graycatlabs/UTCape/README.md

# UTCape

A BeagleBone Black cape to support unit tests in software libraries like PyBBIO 
and Bonsescript. 

The current concept would allow testing of GPIO, UART, SPI, I2C, ADC, eCAP, PWM,
and eQEP software.
