graycatlabs/UTCape/fab/UTCape-bom.xlsx

# | Designator | Quantity | Description | Manufacturer | Mfg. part number | Supplier | Supplier part number | URL
1 | C1 | 1 | CAP CER 10000PF 50V 10% X7R 0603 | Murata | GRM188R71H103KA01D | Digi-Key | 490-1512-1-ND | http://www.digikey.com/product-detail/en/GRM188R71H103KA01D/490-1512-1-ND/587862
2 | C2 C3 C4 C5 C6 C8 C9 | 7 | CAP CER 0.1UF 50V 10% X7R 0603 | Murata | GRM188R71H104KA93D | Digi-Key | 490-1519-1-ND | http://www.digikey.com/product-detail/en/GRM188R71H104KA93D/490-1519-1-ND/587854
3 | C7 | 1 | CAP CER 1000PF 50V 10% X7R 0603 | Murata | GRM188R71H102KA01D | Digi-Key | 490-1494-1-ND | http://www.digikey.com/product-detail/en/GRM188R71H102KA01D/490-1494-1-ND/587851
4 | D1 | 1 | DIODE GEN PURP 75V 150MA SOD523 | Micro Commercial Co | 1N4148X-TP | Digi-Key | 1N4148XTPMSCT-ND | http://www.digikey.com/product-detail/en/1N4148X-TP/1N4148XTPMSCT-ND/789335
5 | IC1 | 1 | IC SINGLE 2-INPUT MUX 6TSSOP | NXP Semiconductors | 74LVC1G157GW,125 | Digi-Key | 568-3008-1-ND | http://www.digikey.com/product-detail/en/74LVC1G157GW,125/568-3008-1-ND/1023416
6 | IC2 | 1 | IC EEPROM 1KBIT 10MHZ SOT23-6 | Microchip | 25LC010AT-I/OT | Digi-Key | 25LC010AT-I/OTCT-ND | http://www.digikey.com/product-detail/en/25LC010AT-I%2FOT/25LC010AT-I%2FOTCT-ND/1212542
7 | IC3 IC4 | 2 | IC EEPROM 256KBIT 400KHZ 8SOIC | Microchip | 24LC256T-I/SN | Digi-Key | 24LC256T-I/SNCT-ND | http://www.digikey.com/product-detail/en/24LC01BT-I%2FOT/24LC01BT-I%2FOTCT-ND/721417
8 | IC5 | 1 | IC OSC SGL TIMER 2.1MHZ 8-SOIC | Texas Instruments | TLC555CDR | Digi-Key | 296-1336-1-ND | http://www.digikey.com/product-detail/en/TLC555CDR/296-1336-1-ND/404959
9 | J1, J2 | 1 | CONN HEADER .100" DUAL STR 46POS | Sullins Connector Solutions | PREC023DAAN-RC | Digi-Key | S2012EC-23-ND | http://www.digikey.com/product-detail/en/PREC023DAAN-RC/S2012EC-23-ND/2774871
10 | R1 R2 R3 R4 R5 R6 R7 R8 R10 R18 | 10 | RES SMD 5.6K OHM 1% 1/10W 0603 | Rohm Semiconductor | MCR03ERTF5601 | Digi-Key | RHM5.6KCFCT-ND | http://www.digikey.com/product-detail/en/MCR03ERTF5601/RHM5.6KCFCT-ND/4084252
11 | R9 R11 R13 R14 | 4 | RES SMD 10K OHM 1% 1/10W 0603 | Rohm Semiconductor | MCR03EZPFX1002 | Digi-Key | RHM10.0KHCT-ND | http://www.digikey.com/product-detail/en/MCR03EZPFX1002/RHM10.0KHCT-ND/628332
12 | R12 R15 R16 R17 R19 R20 | 6 | RES SMD 100 OHM 1% 1/10W 0603 | Rohm Semiconductor | MCR03ERTF1000 | Digi-Key | RHM100CFCT-ND | http://www.digikey.com/product-detail/en/MCR03ERTF1000/RHM100CFCT-ND/2796458
13 | TP1 TP2 TP3 TP4 TP5 TP6 TP7 TP8 TP9 TP10 TP11 TP12 TP13 TP14 TP15 TP16 TP17 | 17 | PC TEST POINT COMPACT SMT | Keystone Electronics | 5016 | Digi-Key | 5016KCT-ND | http://www.digikey.com/product-detail/en/5016/5016KCT-ND/278888
