graycatlabs/UTCape/UTCape.pdf

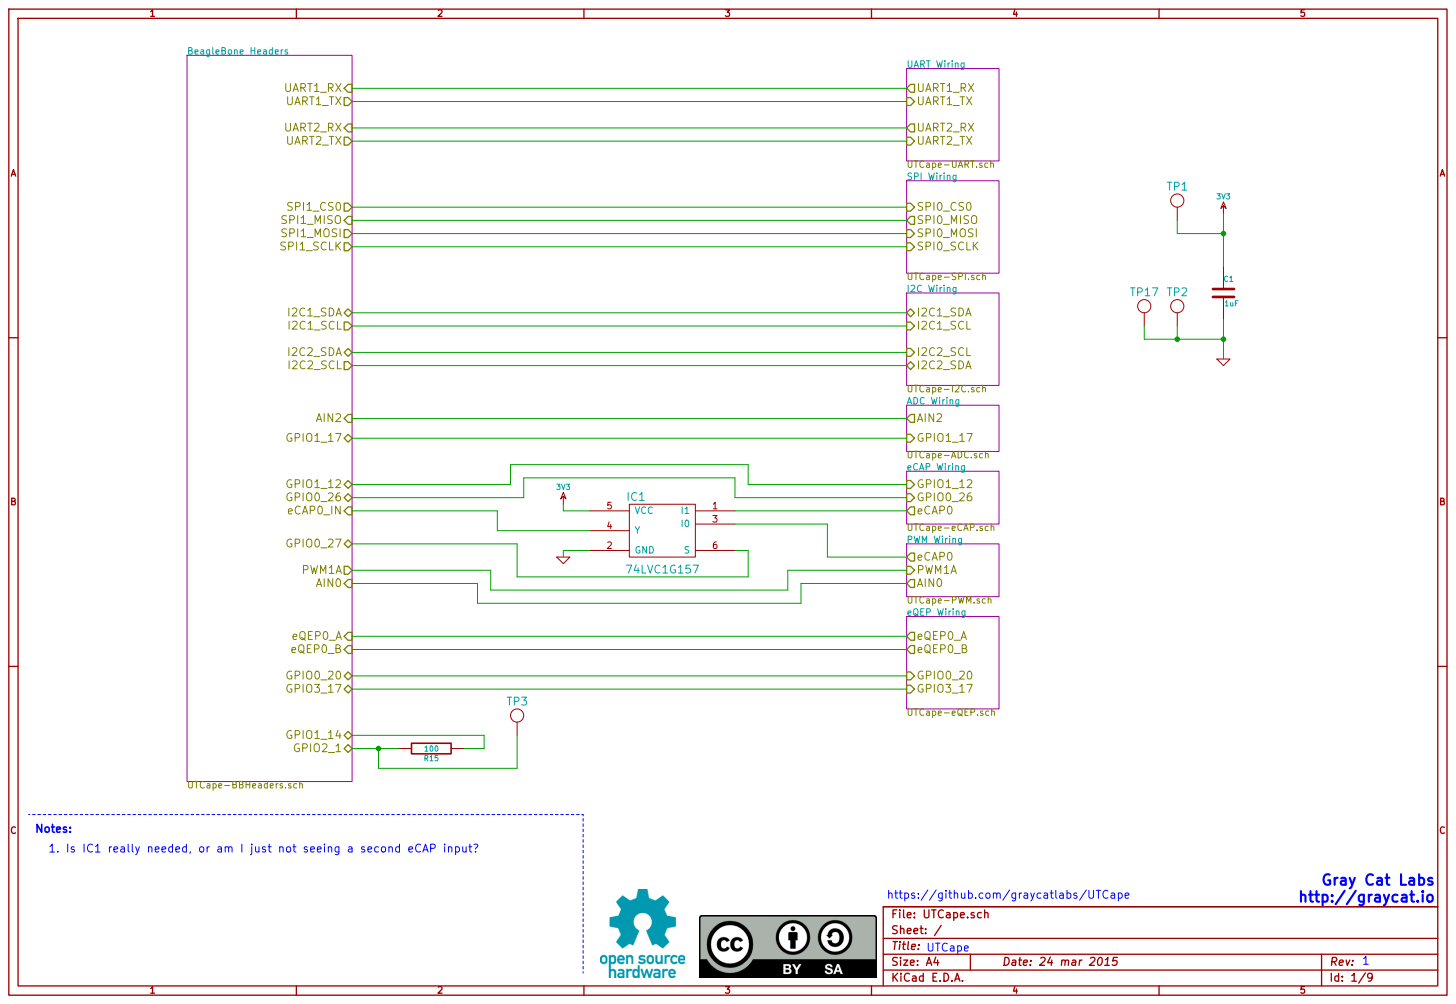
[picture p1: page 1]

Notes: 1. Is IC1 really needed, or am I just not seeing a second eCAP input?

Id: 1/9 Title: File: UTCape.sch
Sheet: /
UTCape

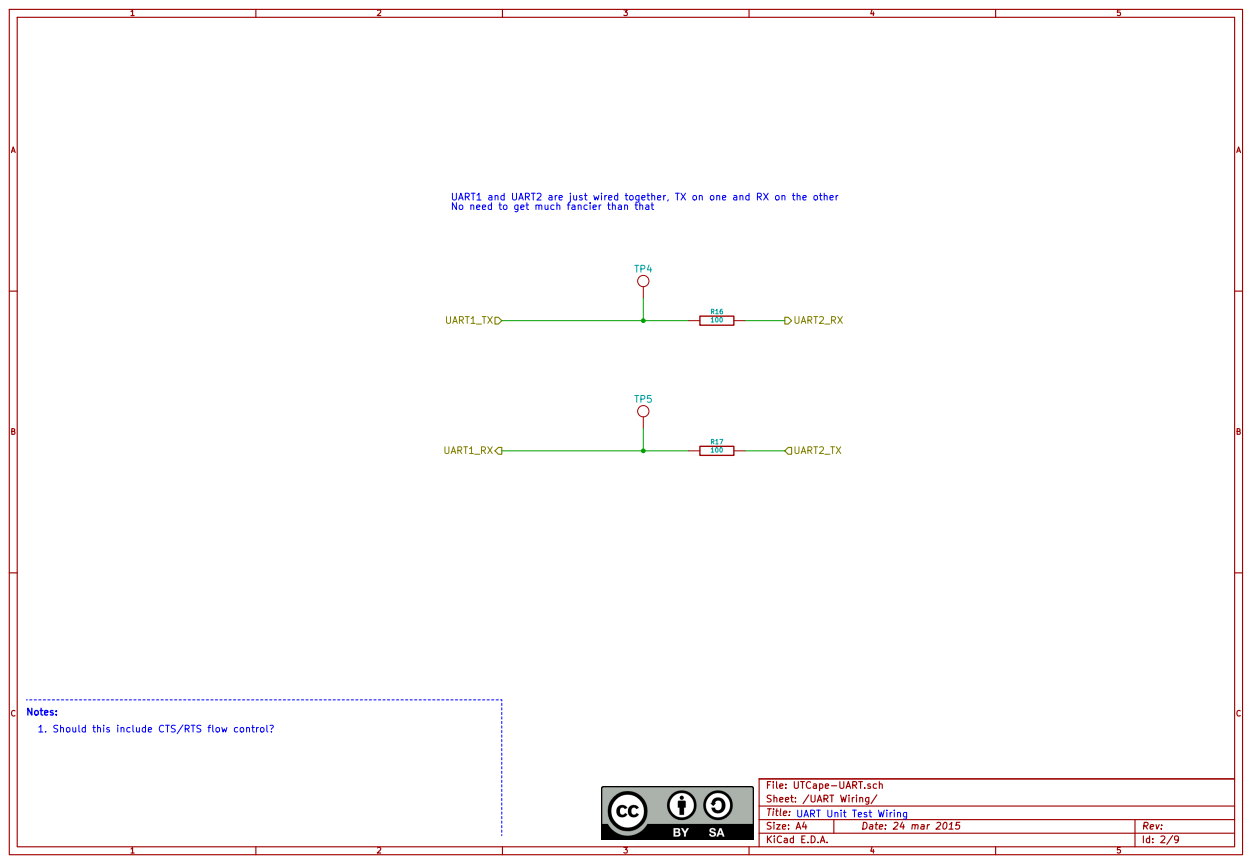
[picture p2: page 2]

UART1 and UART2 are just wired together, TX on one and RX on the other
No need to get much fancier than that

1. Should this include CTS/RTS flow control? Notes:

Id: 2/9 Title: File: UTCape-UART.sch
Sheet: /UART Wiring/

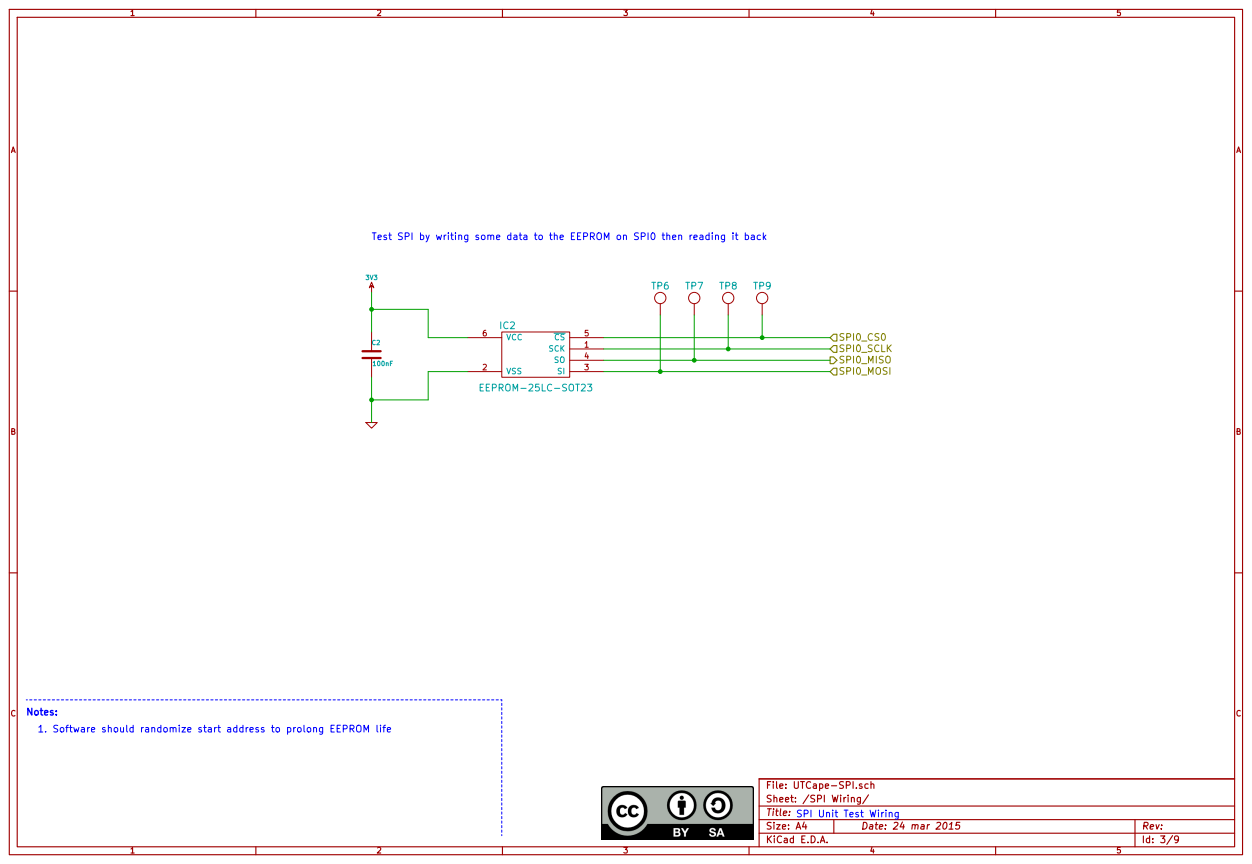
[picture p3: page 3]

Test SPI by writing some data to the EEPROM on SPI0 then reading it back Notes: 1. Software should randomize start address to prolong EEPROM life

Id: 3/9 Title: File: UTCape-SPI.sch
Sheet: /SPI Wiring/
SPI Unit Test Wiring

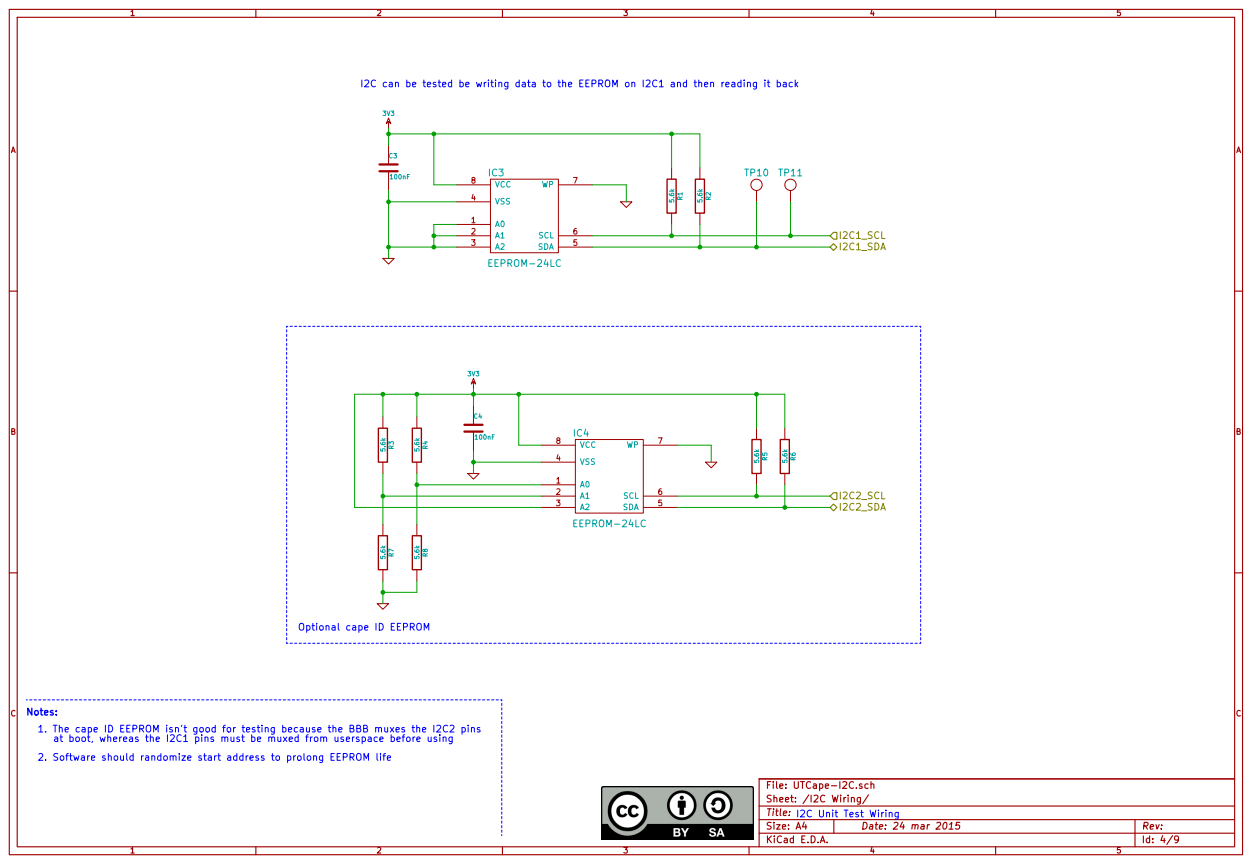
[picture p4: page 4]

I2C can be tested be writing data to the EEPROM on I2C1 and then reading it back Notes: 1. The cape ID EEPROM isn't good for testing because the BBB muxes the I2C2 pins

Optional cape ID EEPROM

at boot, whereas the I2C1 pins must be muxed from userspace before using
2. Software should randomize start address to prolong EEPROM life

Id: 4/9 Title: File: UTCape-I2C.sch
Sheet: /I2C Wiring/
I2C Unit Test Wiring

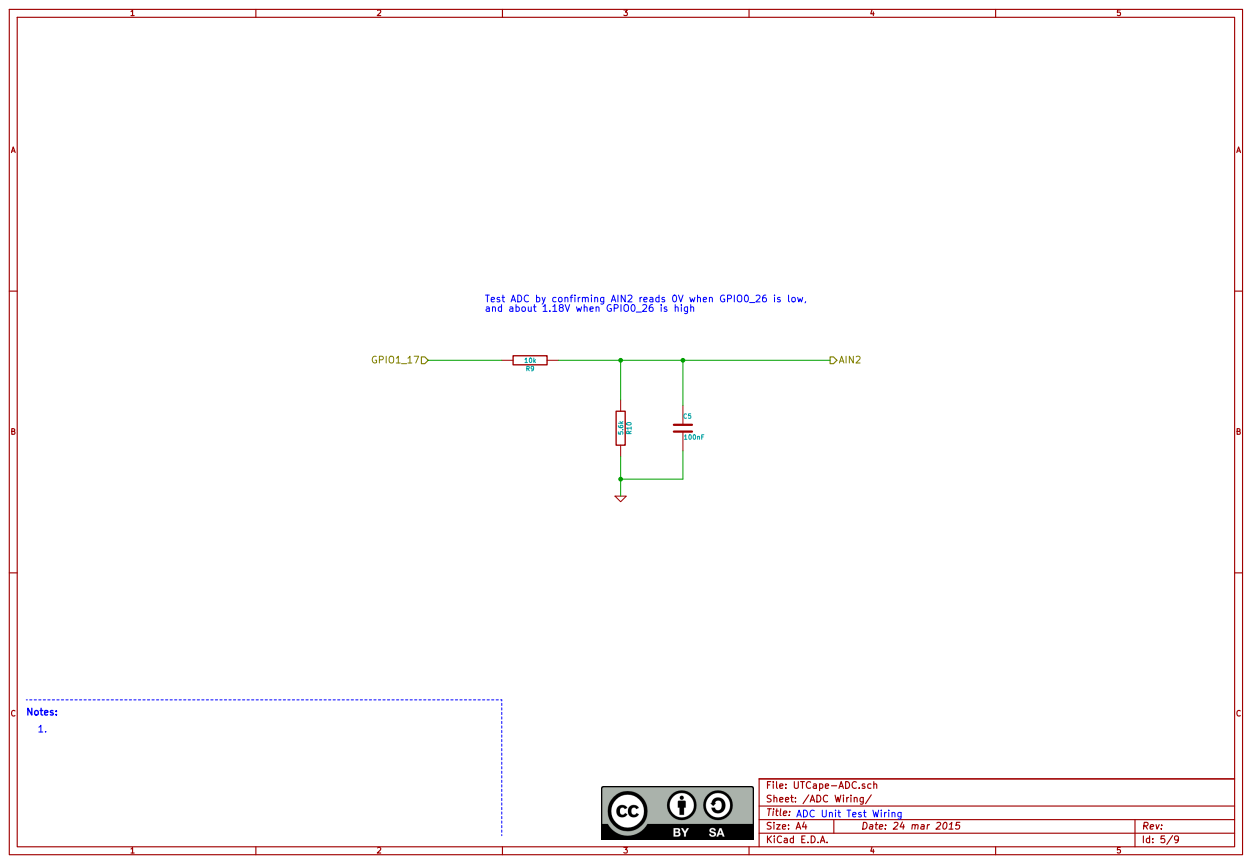
[picture p5: page 5]

100nF Test ADC by confirming AIN2 reads 0V when GPIO0_26 is low,
and about 1.18V when GPIO0_26 is high

Id: 5/9 Title: File: UTCape-ADC.sch
Sheet: /ADC Wiring/

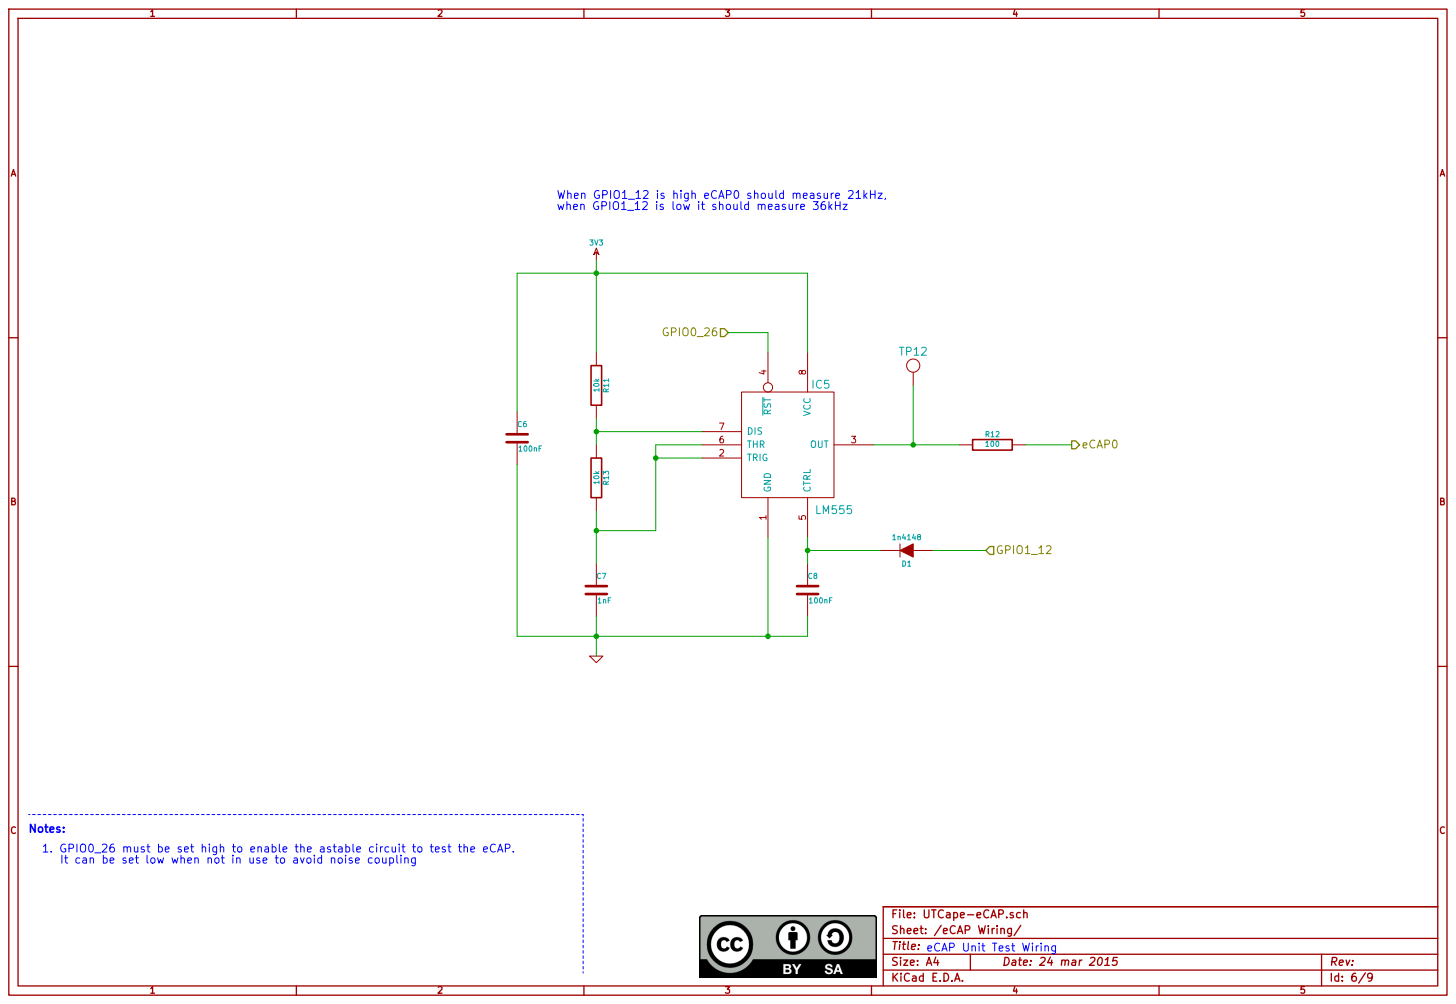
[picture p6: page 6]

When GPIO1_12 is high eCAP0 should measure 21kHz,
when GPIO1_12 is low it should measure 36kHz

100nF Notes: 1. GPIO0_26 must be set high to enable the astable circuit to test the eCAP.

It can be set low when not in use to avoid noise coupling

Id: 6/9 Title: File: UTCape-eCAP.sch
Sheet: /eCAP Wiring/
eCAP Unit Test Wiring

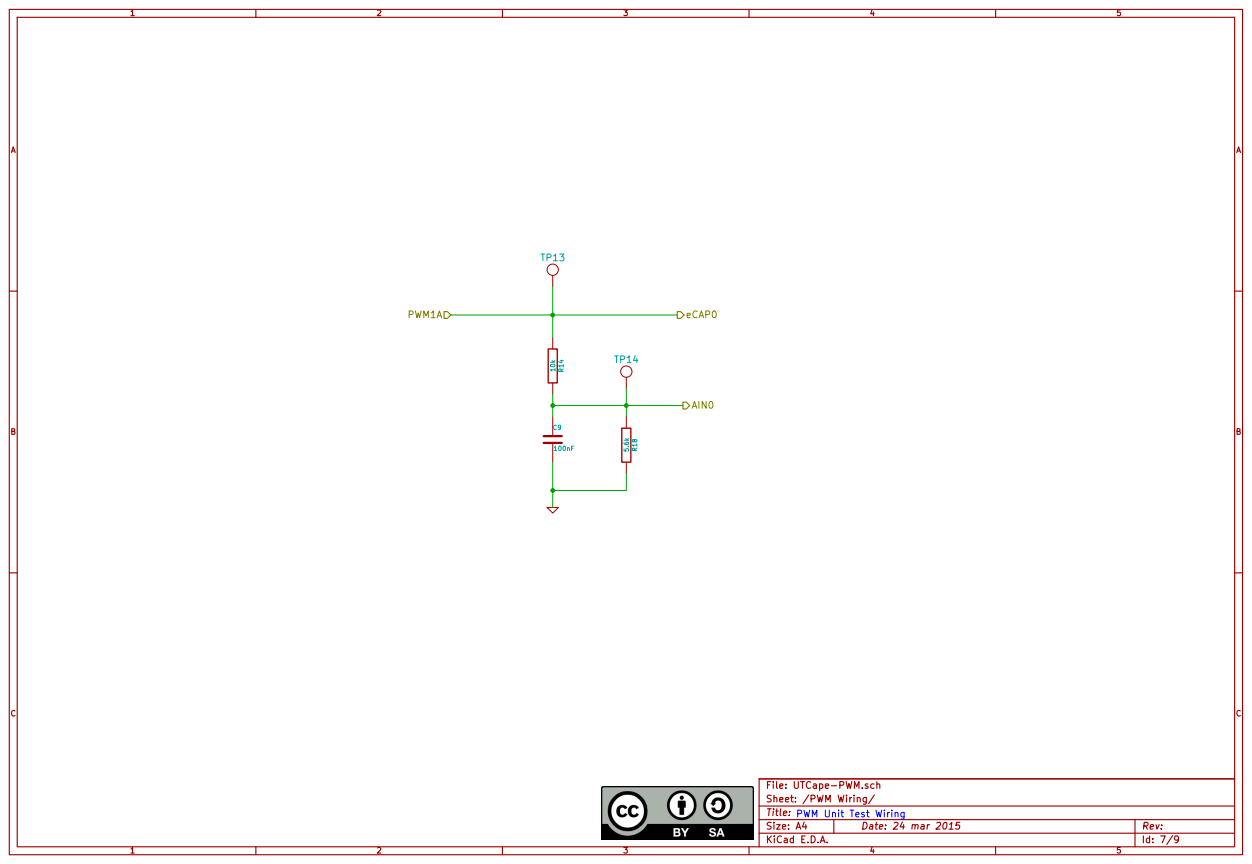
[picture p7: page 7]

Id: 7/9 Title: File: UTCape-PWM.sch
Sheet: /PWM Wiring/

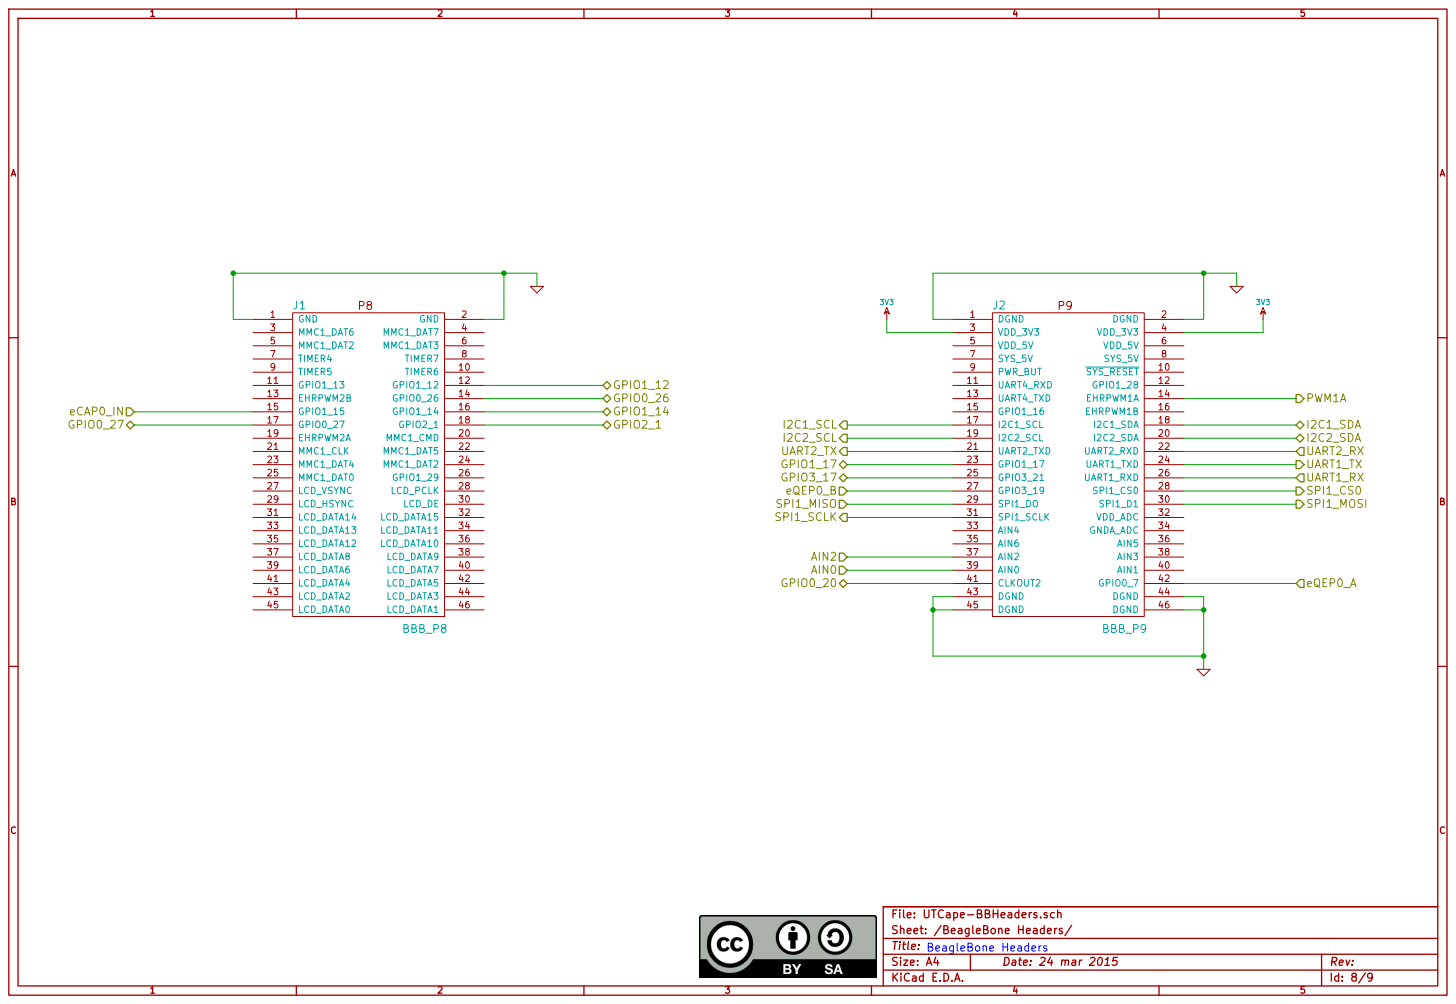
[picture p8: page 8]

Id: 8/9 Title: File: UTCape-BBHeaders.sch
Sheet: /BeagleBone Headers/
BeagleBone Headers

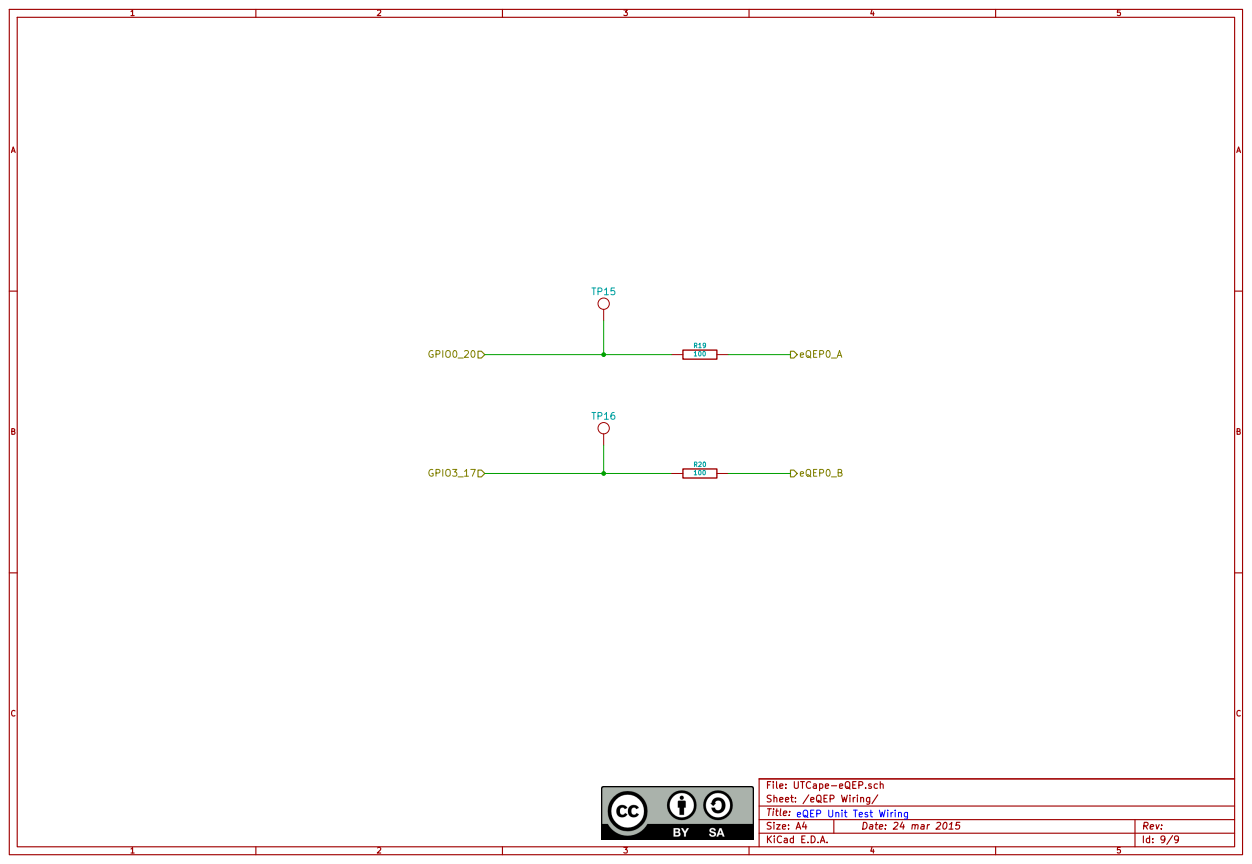
[picture p9: page 9]

Id: 9/9 Title: File: UTCape-eQEP.sch
Sheet: /eQEP Wiring/
eQEP Unit Test Wiring
