graycatlabs/UTCape/UTCape-KiCad/UTCape.kicad_pcb

## KiCad design UTCape-KiCad/UTCape.kicad_pcb (2015-03-24)

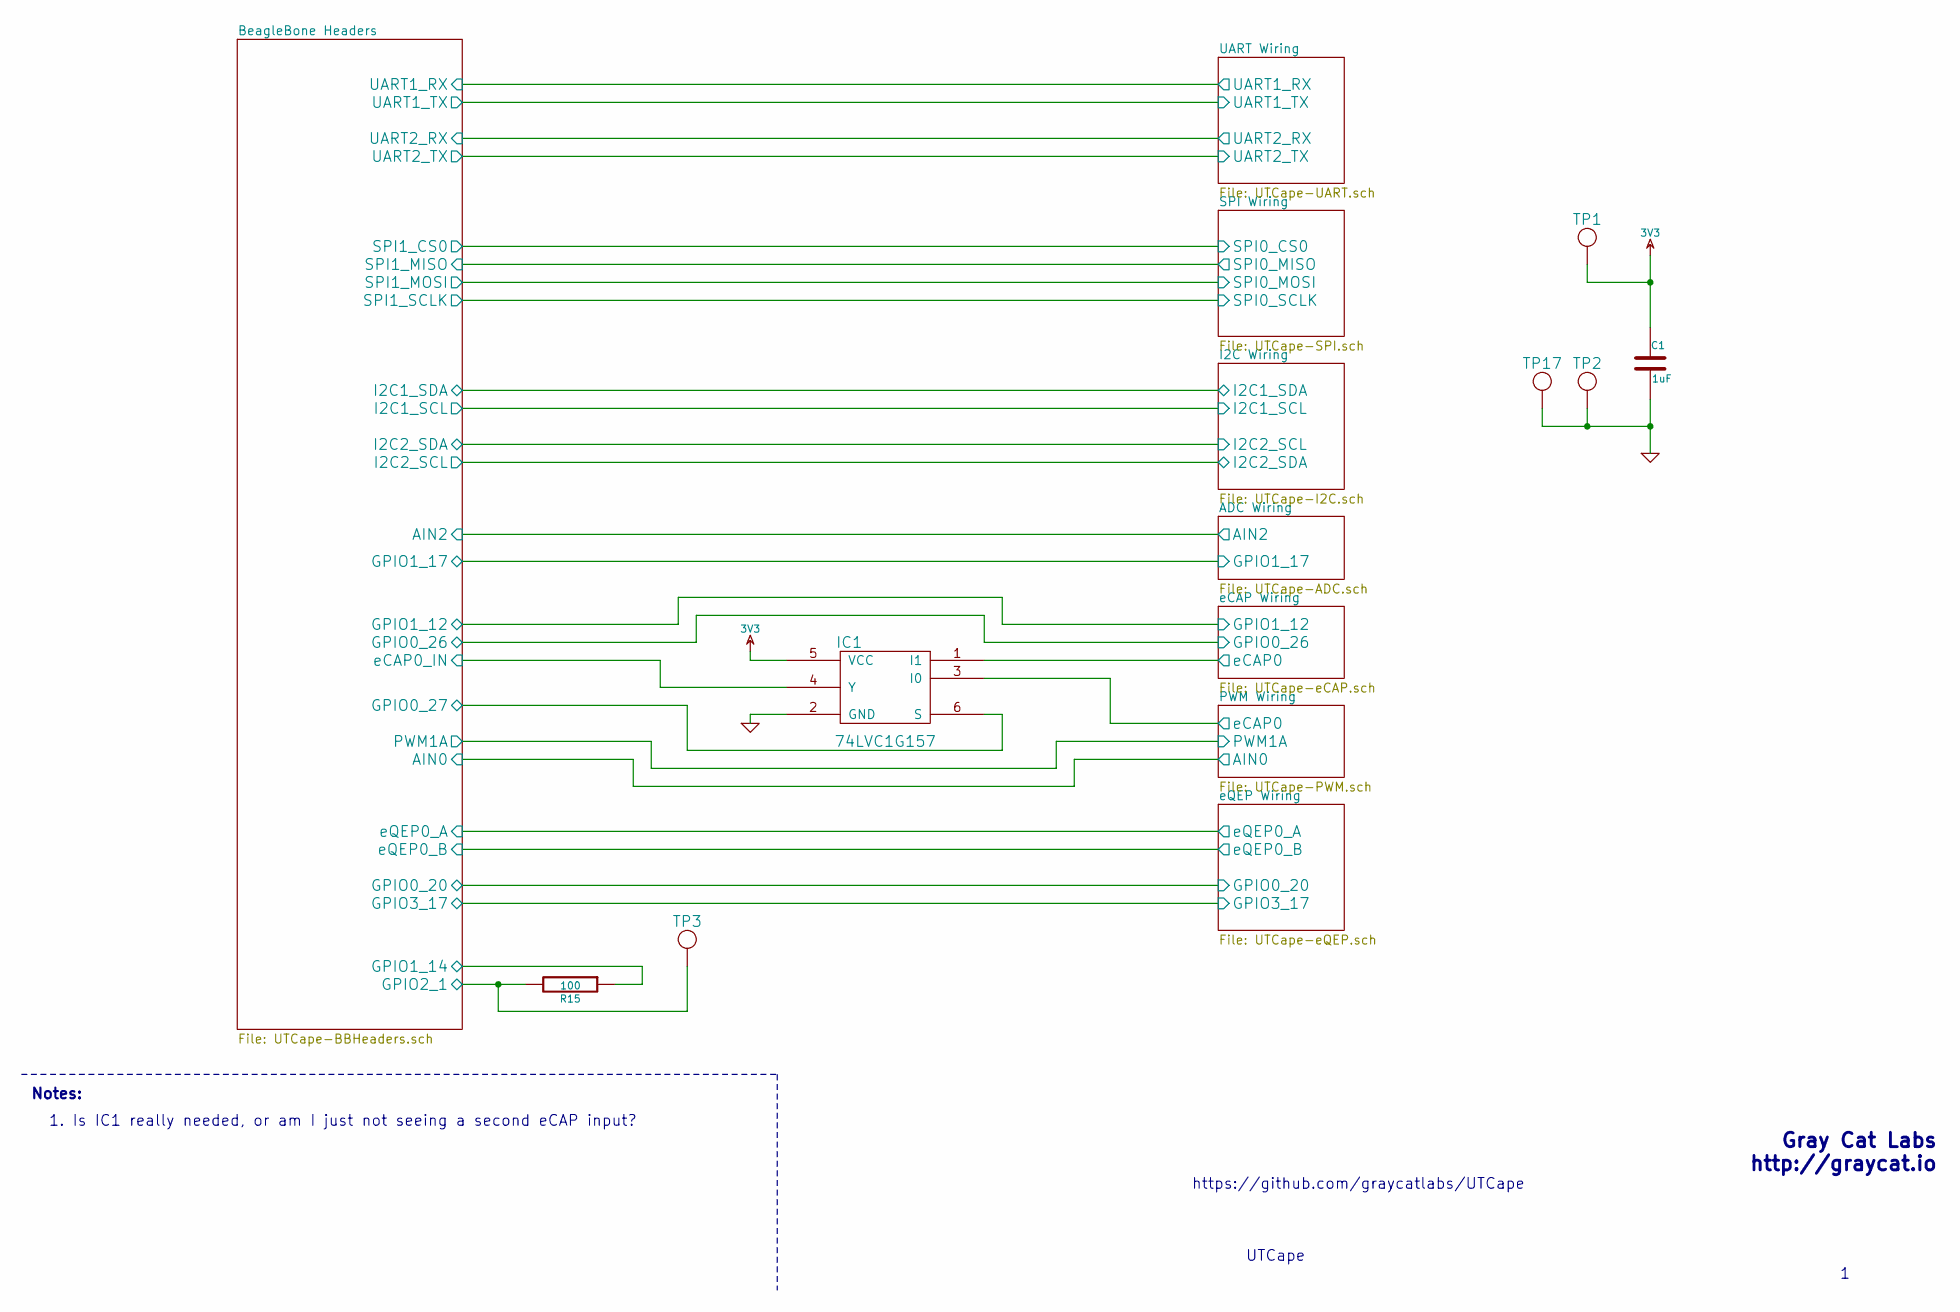
[picture p10: schematic UTCape.sch]

Parts:
C1: 1uF
IC1: 74LVC1G157; Mfg. part num. 74LVC1G157GW
R15: 100
TP1, TP2, TP3, TP17: TEST_POINT

Connections:
3V3: C1.1, IC1.5 (VCC), TP1.1; also elsewhere on the board
/BeagleBone Headers/GPIO0_27: IC1.6 (S); also elsewhere on the board
/BeagleBone Headers/GPIO1_14: R15.1; also elsewhere on the board
/BeagleBone Headers/GPIO2_1: R15.2, TP3.1; also elsewhere on the board
/BeagleBone Headers/PWM1A: IC1.3 (I0); also elsewhere on the board
/BeagleBone Headers/eCAP0_IN: IC1.4 (Y); also elsewhere on the board
/eCAP Wiring/eCAP0: IC1.1 (I1); also elsewhere on the board
GND: C1.2, IC1.2 (GND), TP2.1, TP17.1; also elsewhere on the board

Notes on the sheet:
UTCape
Gray Cat Labs http://graycat.io
https://github.com/graycatlabs/UTCape
Notes:
1. Is IC1 really needed, or am I just not seeing a second eCAP input?

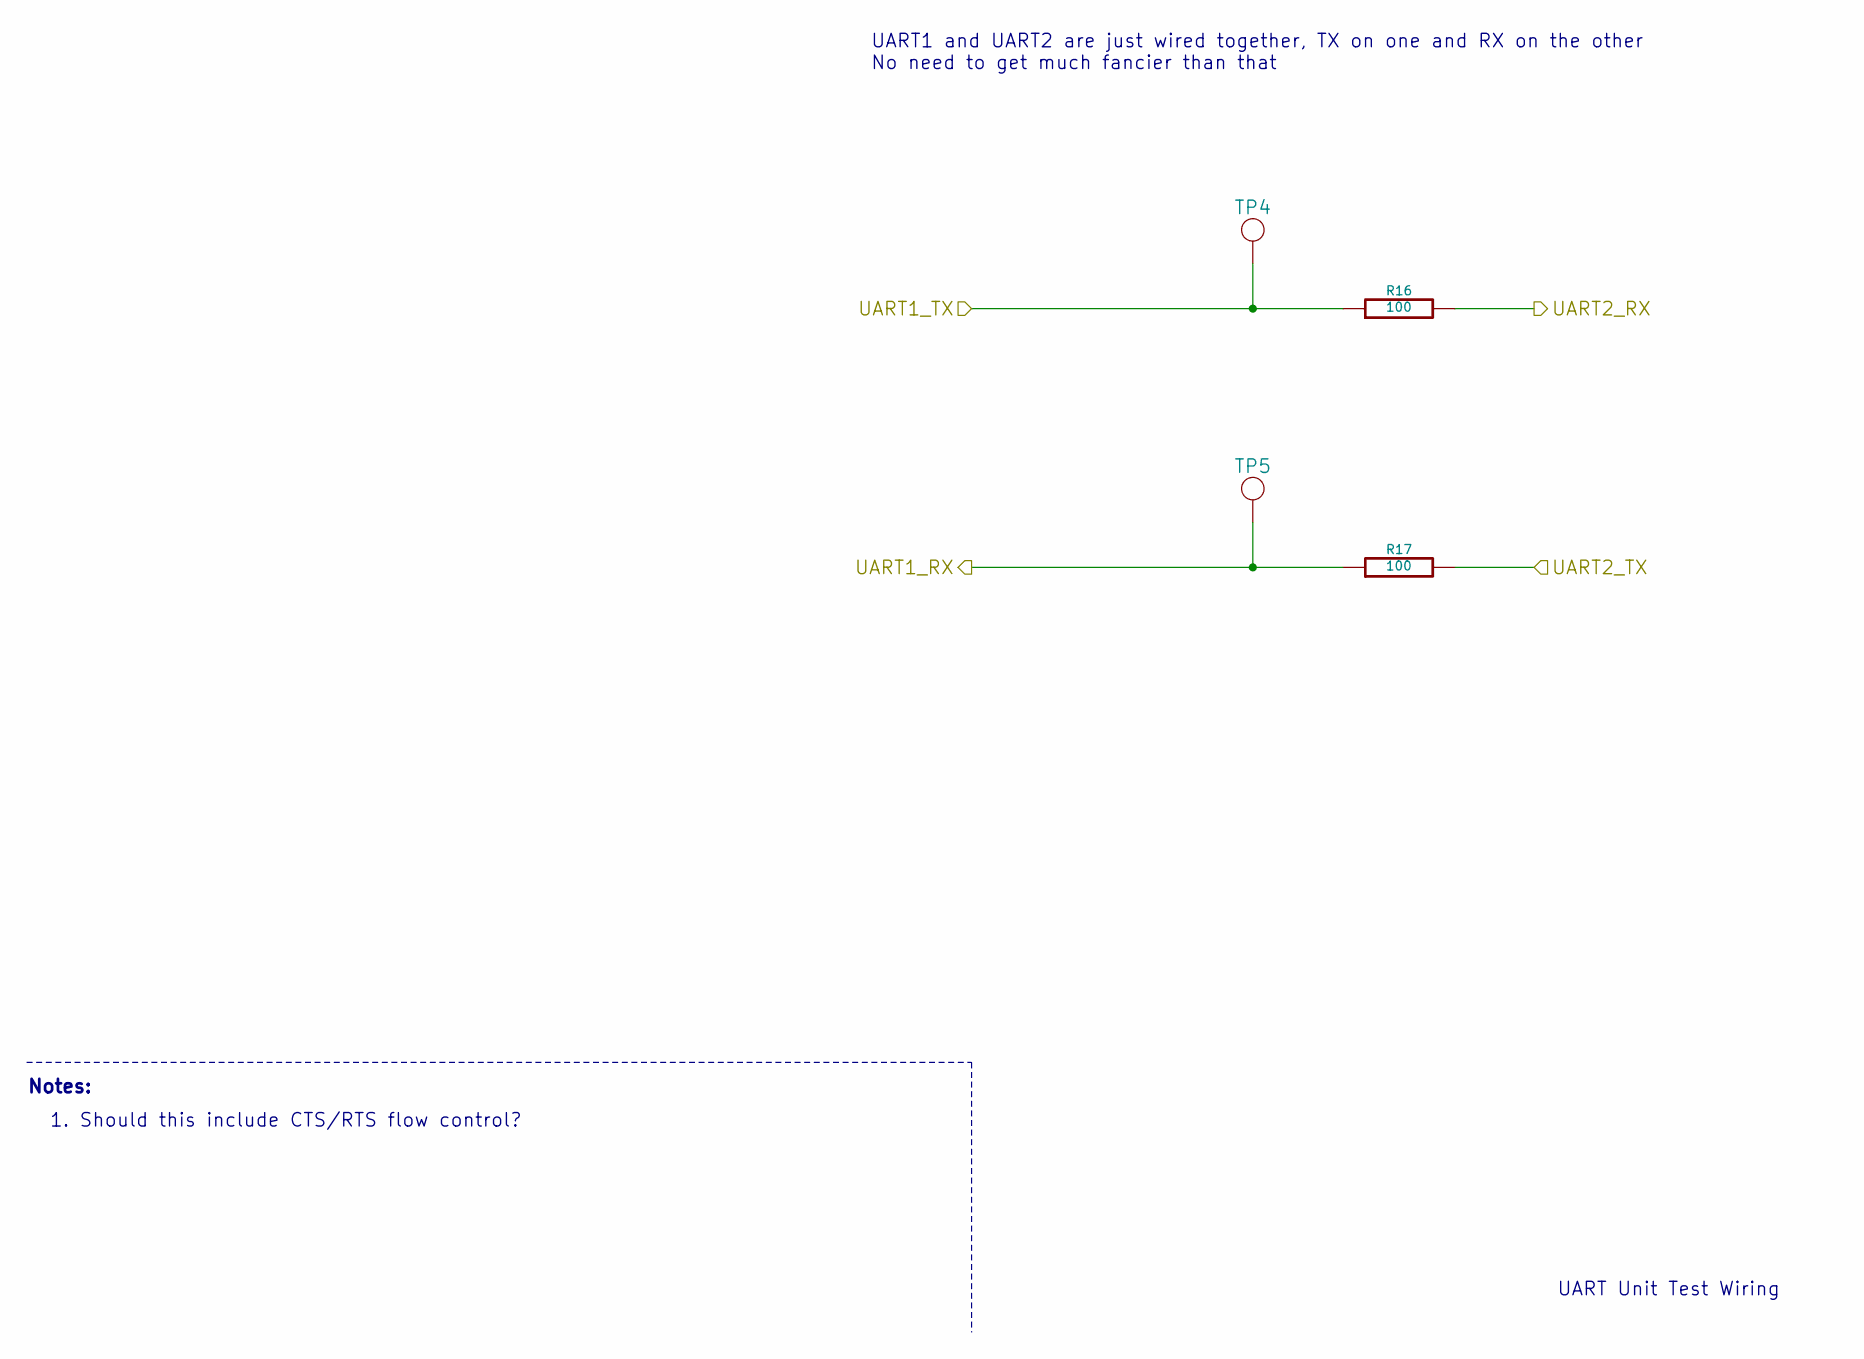
[picture p11: schematic UTCape-UART.sch]

Parts:
R16, R17: 100
TP4, TP5: TEST_POINT

Connections:
/BeagleBone Headers/UART1_RX: R17.1, TP5.1; also elsewhere on the board
/BeagleBone Headers/UART1_TX: R16.1, TP4.1; also elsewhere on the board
/BeagleBone Headers/UART2_RX: R16.2; also elsewhere on the board
/BeagleBone Headers/UART2_TX: R17.2; also elsewhere on the board

Notes on the sheet:
UART Unit Test Wiring
UART1 and UART2 are just wired together, TX on one and RX on the other No need to get much fancier than that
1. Should this include CTS/RTS flow control?
Notes:

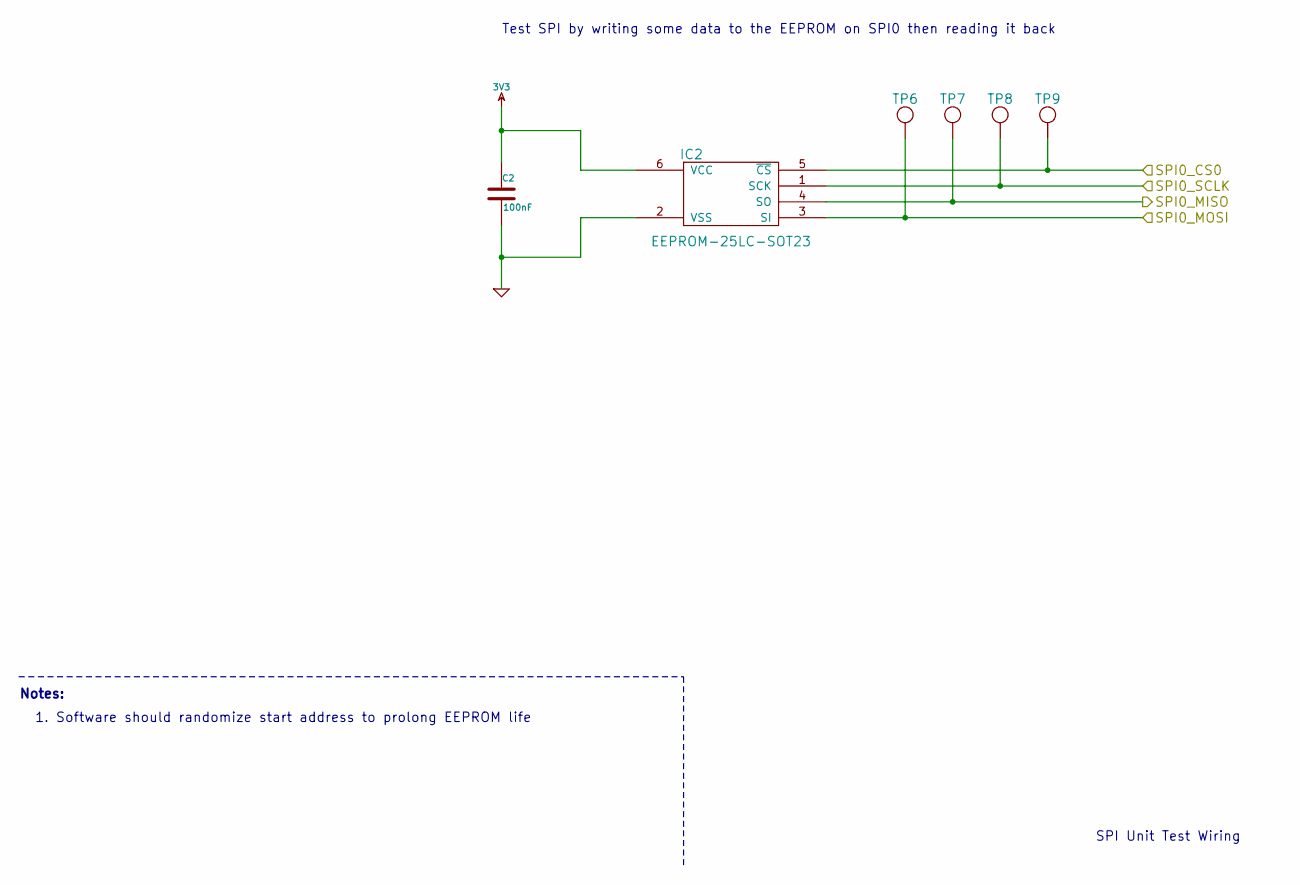
[picture p12: schematic UTCape-SPI.sch]

Parts:
C2: 100nF
IC2: EEPROM-25LC-SOT23
TP6, TP7, TP8, TP9: TEST_POINT

Connections:
3V3: C2.1, IC2.6 (VCC); also elsewhere on the board
/SPI Wiring/SPI0_CS0: IC2.5 (~CS), TP9.1; also elsewhere on the board
/SPI Wiring/SPI0_MISO: IC2.4 (SO), TP7.1; also elsewhere on the board
/SPI Wiring/SPI0_MOSI: IC2.3 (SI), TP6.1; also elsewhere on the board
/SPI Wiring/SPI0_SCLK: IC2.1 (SCK), TP8.1; also elsewhere on the board
GND: C2.2, IC2.2 (VSS); also elsewhere on the board

Notes on the sheet:
SPI Unit Test Wiring
Test SPI by writing some data to the EEPROM on SPI0 then reading it back
Notes:
1. Software should randomize start address to prolong EEPROM life

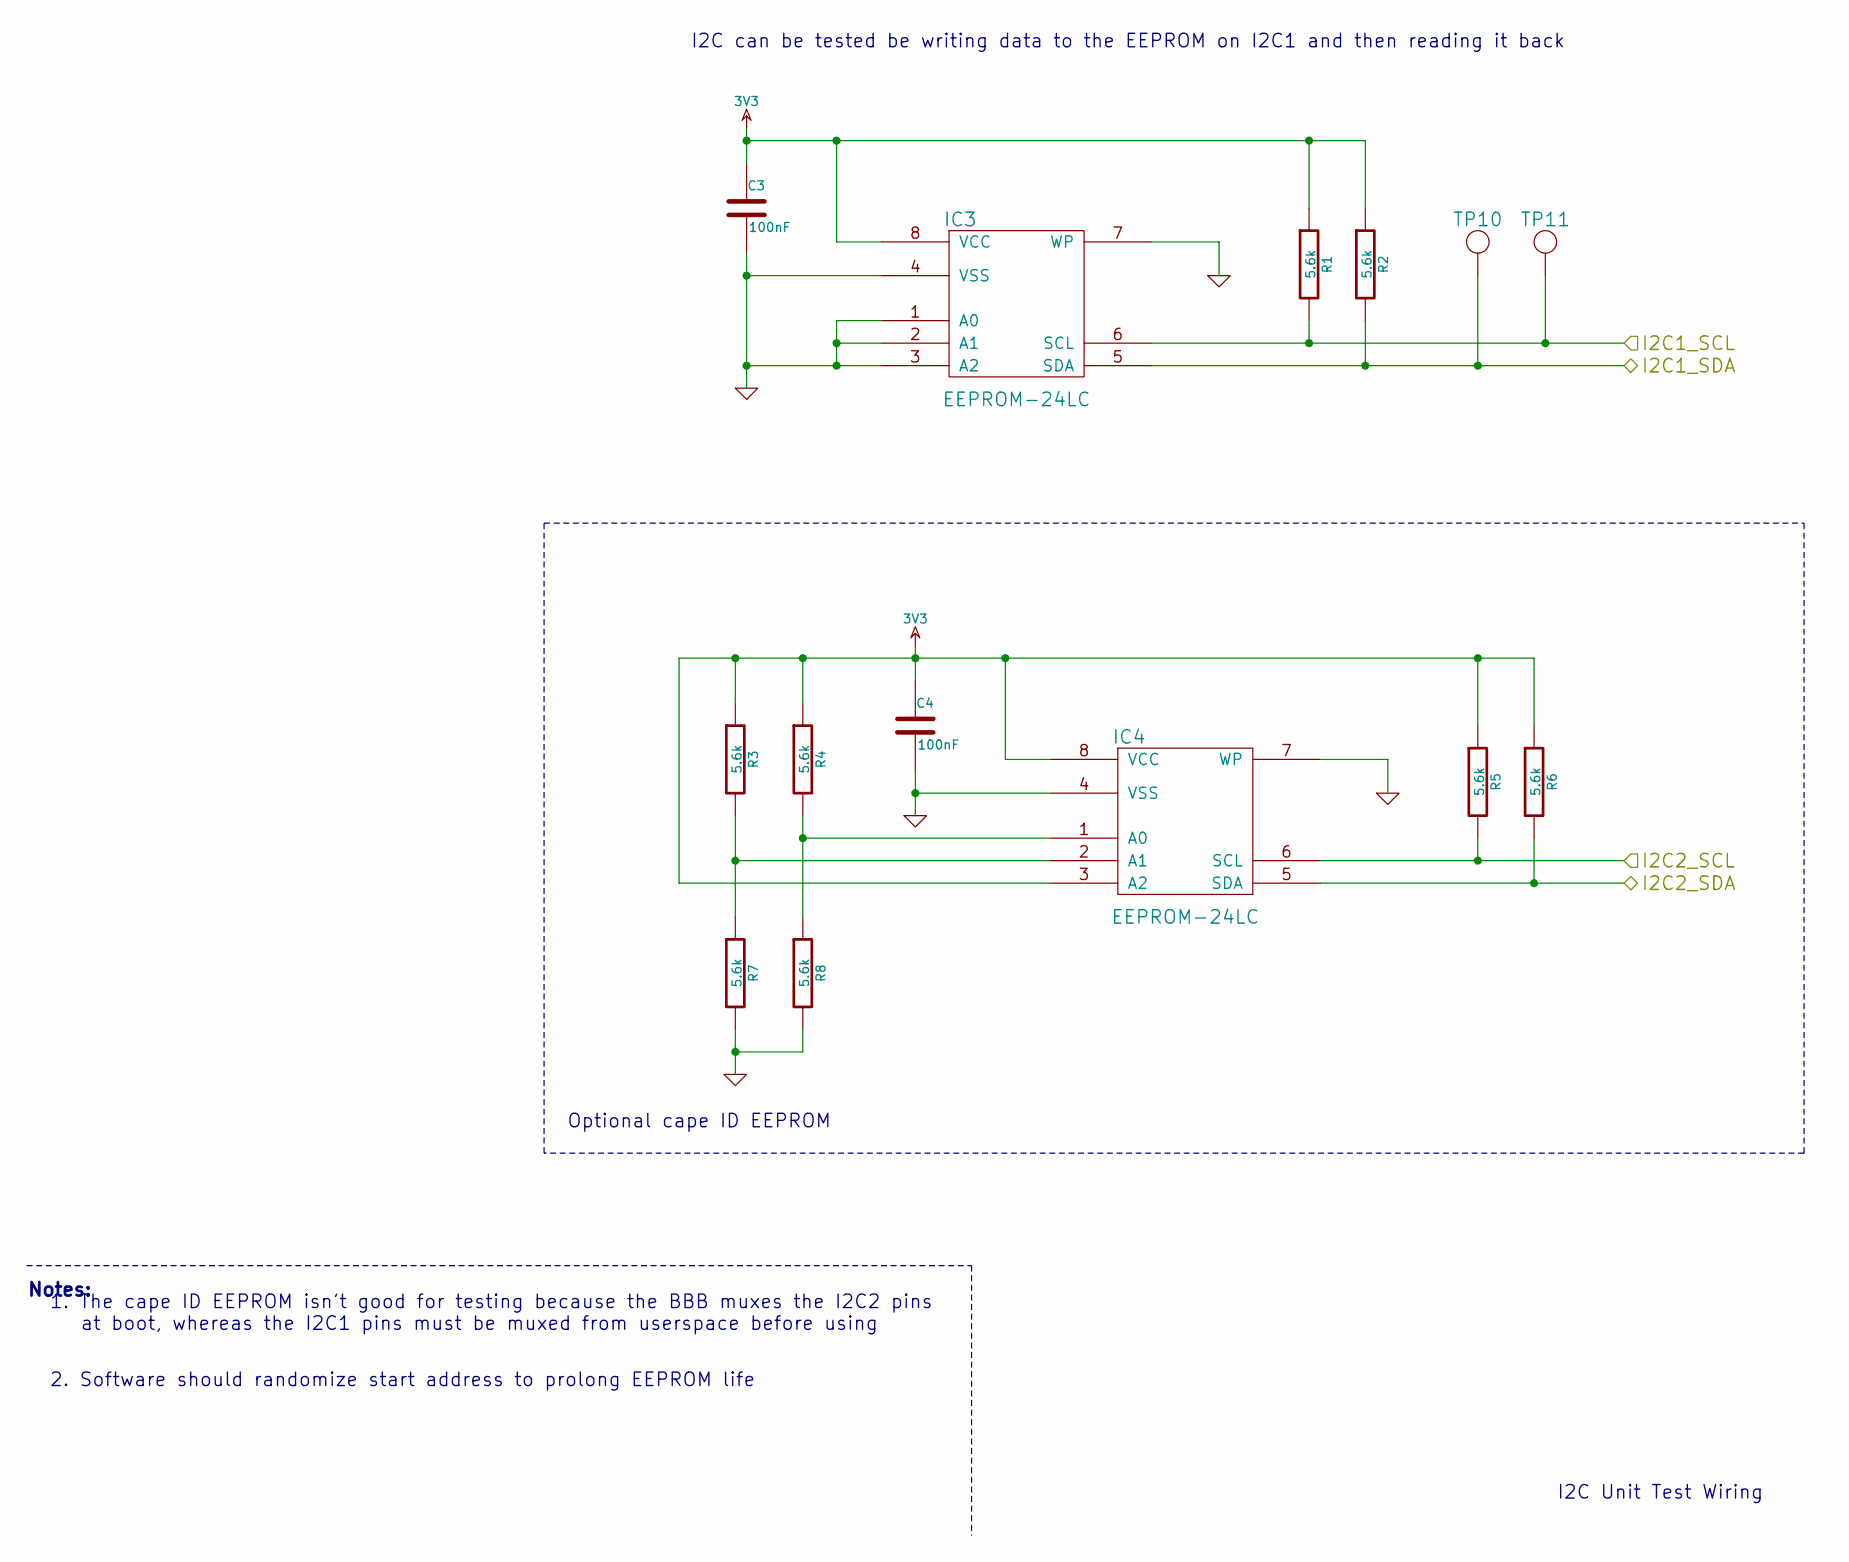
[picture p13: schematic UTCape-I2C.sch]

Parts:
C3, C4: 100nF
IC3, IC4: EEPROM-24LC
R1, R2, R3, R4, R5, R6, R7, R8: 5.6k
TP10, TP11: TEST_POINT

Connections:
3V3: C3.1, C4.1, IC3.8 (VCC), IC4.3 (A2), IC4.8 (VCC), R1.1, R2.1, R3.1, R4.1, R5.1, R6.1; also elsewhere on the board
/BeagleBone Headers/I2C1_SCL: IC3.6 (SCL), R1.2, TP11.1; also elsewhere on the board
/BeagleBone Headers/I2C1_SDA: IC3.5 (SDA), R2.2, TP10.1; also elsewhere on the board
/BeagleBone Headers/I2C2_SCL: IC4.5 (SDA), R6.2; also elsewhere on the board
/I2C Wiring/I2C2_SCL: IC4.6 (SCL), R5.2; also elsewhere on the board
GND: C3.2, C4.2, IC3.1 (A0), IC3.2 (A1), IC3.3 (A2), IC3.4 (VSS), IC3.7 (WP), IC4.4 (VSS), IC4.7 (WP), R7.2, R8.2; also elsewhere on the board
unnamed: IC4.1 (A0), R4.2, R8.1
unnamed: IC4.2 (A1), R3.2, R7.1

Notes on the sheet:
I2C Unit Test Wiring
Optional cape ID EEPROM
I2C can be tested be writing data to the EEPROM on I2C1 and then reading it back
Notes:
1. The cape ID EEPROM isn't good for testing because the BBB muxes the I2C2 pins at boot, whereas the I2C1 pins must be muxed from userspace before using
2. Software should randomize start address to prolong EEPROM life

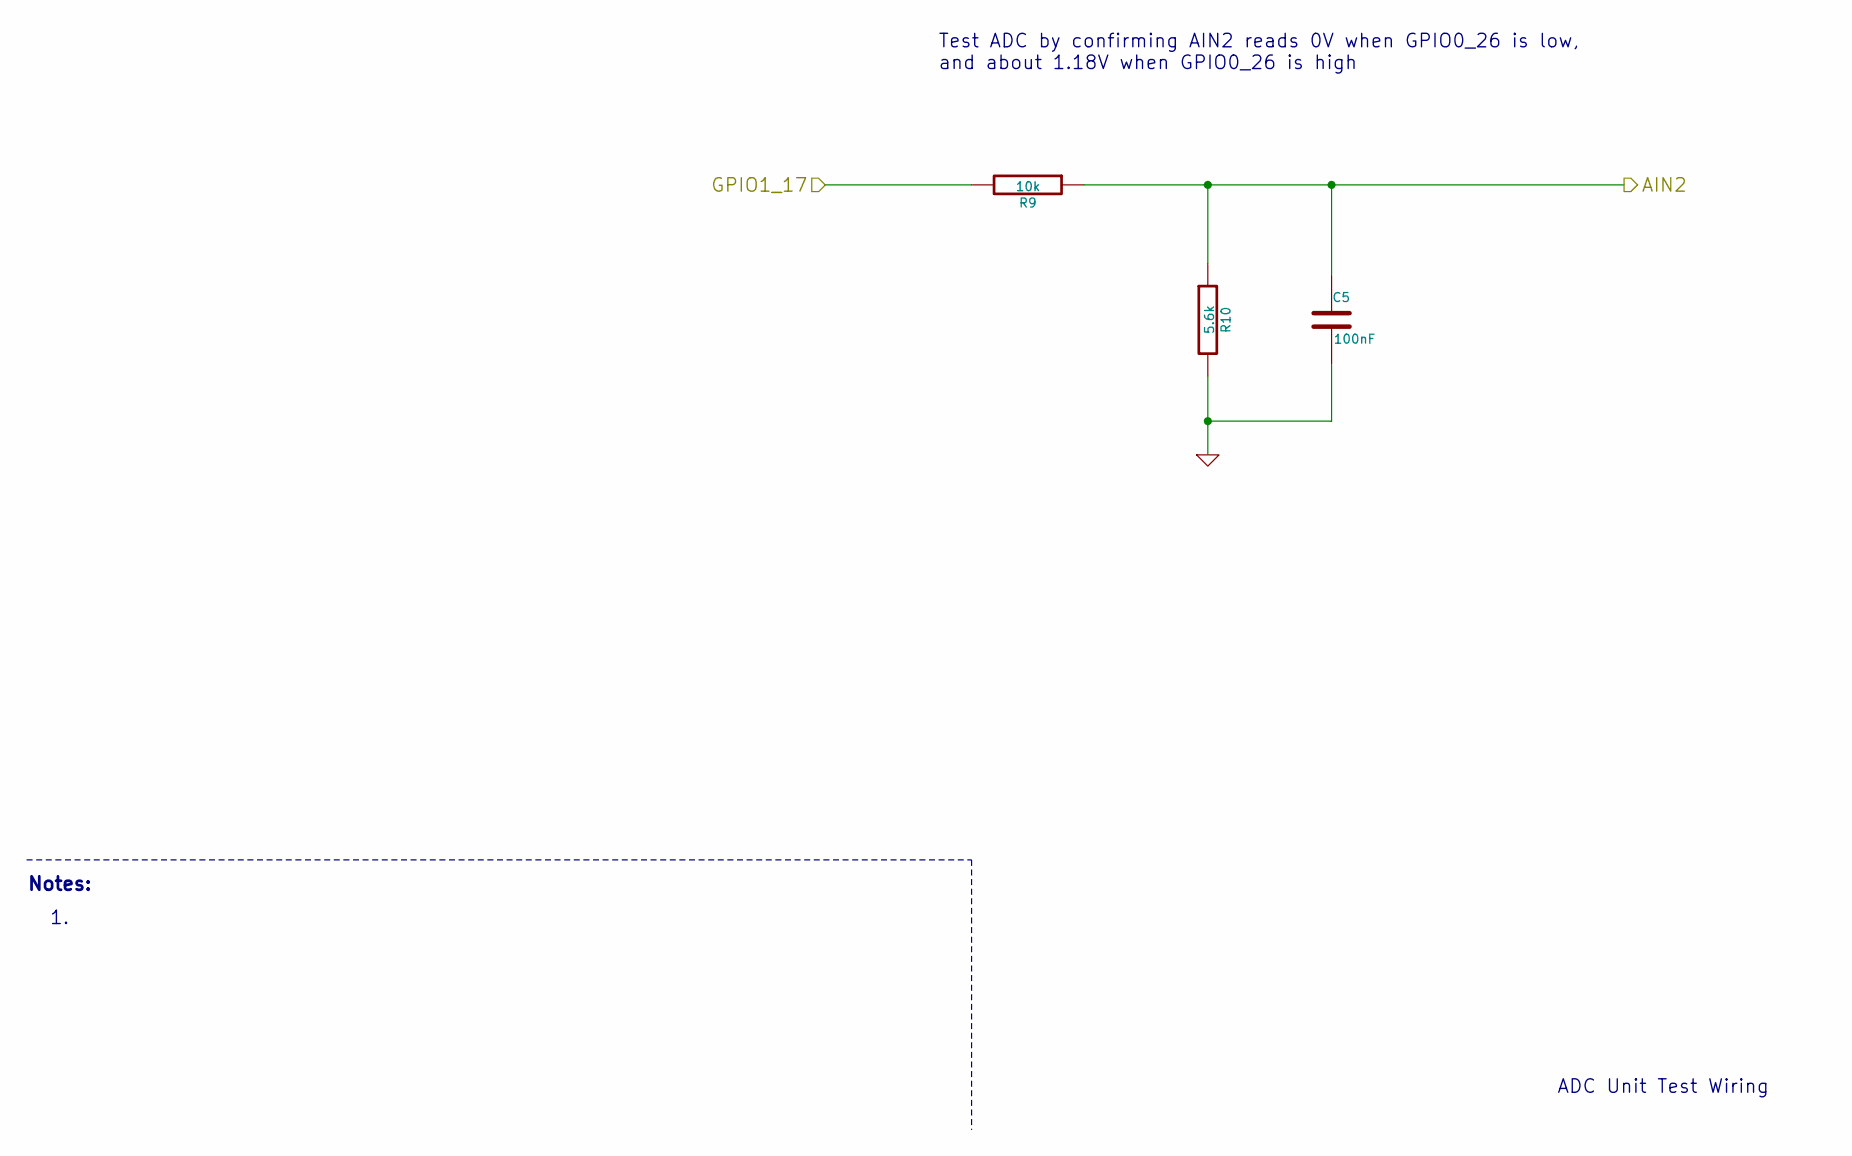
[picture p14: schematic UTCape-ADC.sch]

Parts:
C5: 100nF
R9: 10k
R10: 5.6k

Connections:
/ADC Wiring/AIN2: C5.1, R9.1, R10.1; also elsewhere on the board
/ADC Wiring/GPIO1_17: R9.2; also elsewhere on the board
GND: C5.2, R10.2; also elsewhere on the board

Notes on the sheet:
ADC Unit Test Wiring
Notes:
Test ADC by confirming AIN2 reads 0V when GPIO0_26 is low, and about 1.18V when GPIO0_26 is high

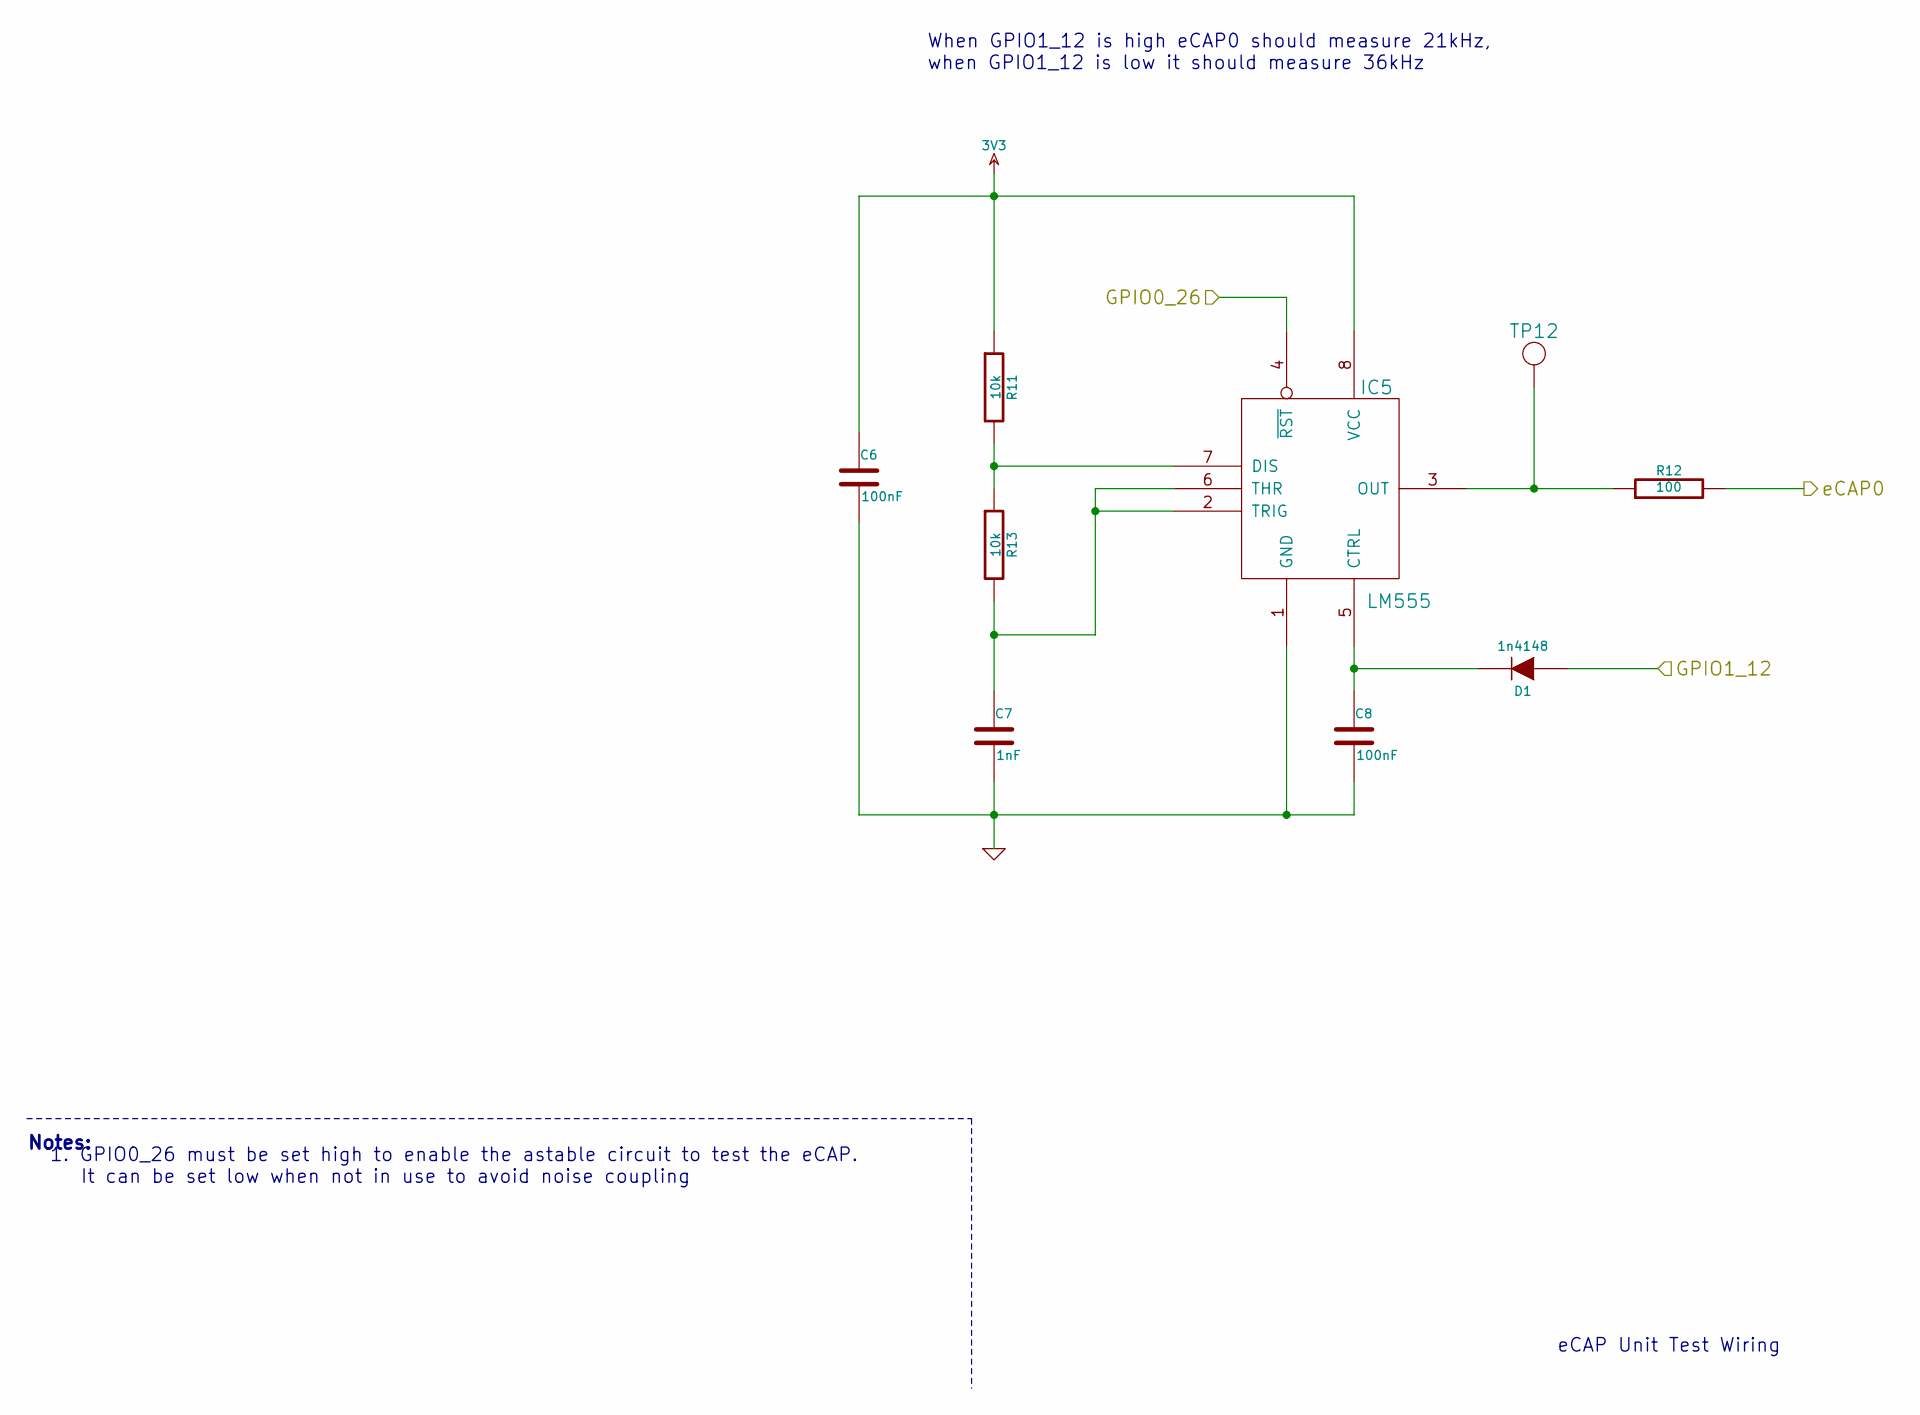
[picture p15: schematic UTCape-eCAP.sch]

Parts:
C6, C8: 100nF
C7: 1nF
D1: 1n4148
IC5: LM555
R11, R13: 10k
R12: 100
TP12: TEST_POINT

Connections:
3V3: C6.1, IC5.8 (VCC), R11.1; also elsewhere on the board
/BeagleBone Headers/GPIO0_26: IC5.4 (~RST); also elsewhere on the board
/BeagleBone Headers/GPIO1_12: D1.1 (A); also elsewhere on the board
/eCAP Wiring/eCAP0: R12.2; also elsewhere on the board
GND: C6.2, C7.2, C8.2, IC5.1 (GND); also elsewhere on the board
unnamed: IC5.7 (DIS), R11.2, R13.1
unnamed: IC5.3 (OUT), R12.1, TP12.1
unnamed: C8.1, D1.2 (K), IC5.5 (CTRL)
unnamed: C7.1, IC5.2 (TRIG), IC5.6 (THR), R13.2

Notes on the sheet:
Notes:
1. GPIO0_26 must be set high to enable the astable circuit to test the eCAP. It can be set low when not in use to avoid noise coupling
When GPIO1_12 is high eCAP0 should measure 21kHz, when GPIO1_12 is low it should measure 36kHz
eCAP Unit Test Wiring

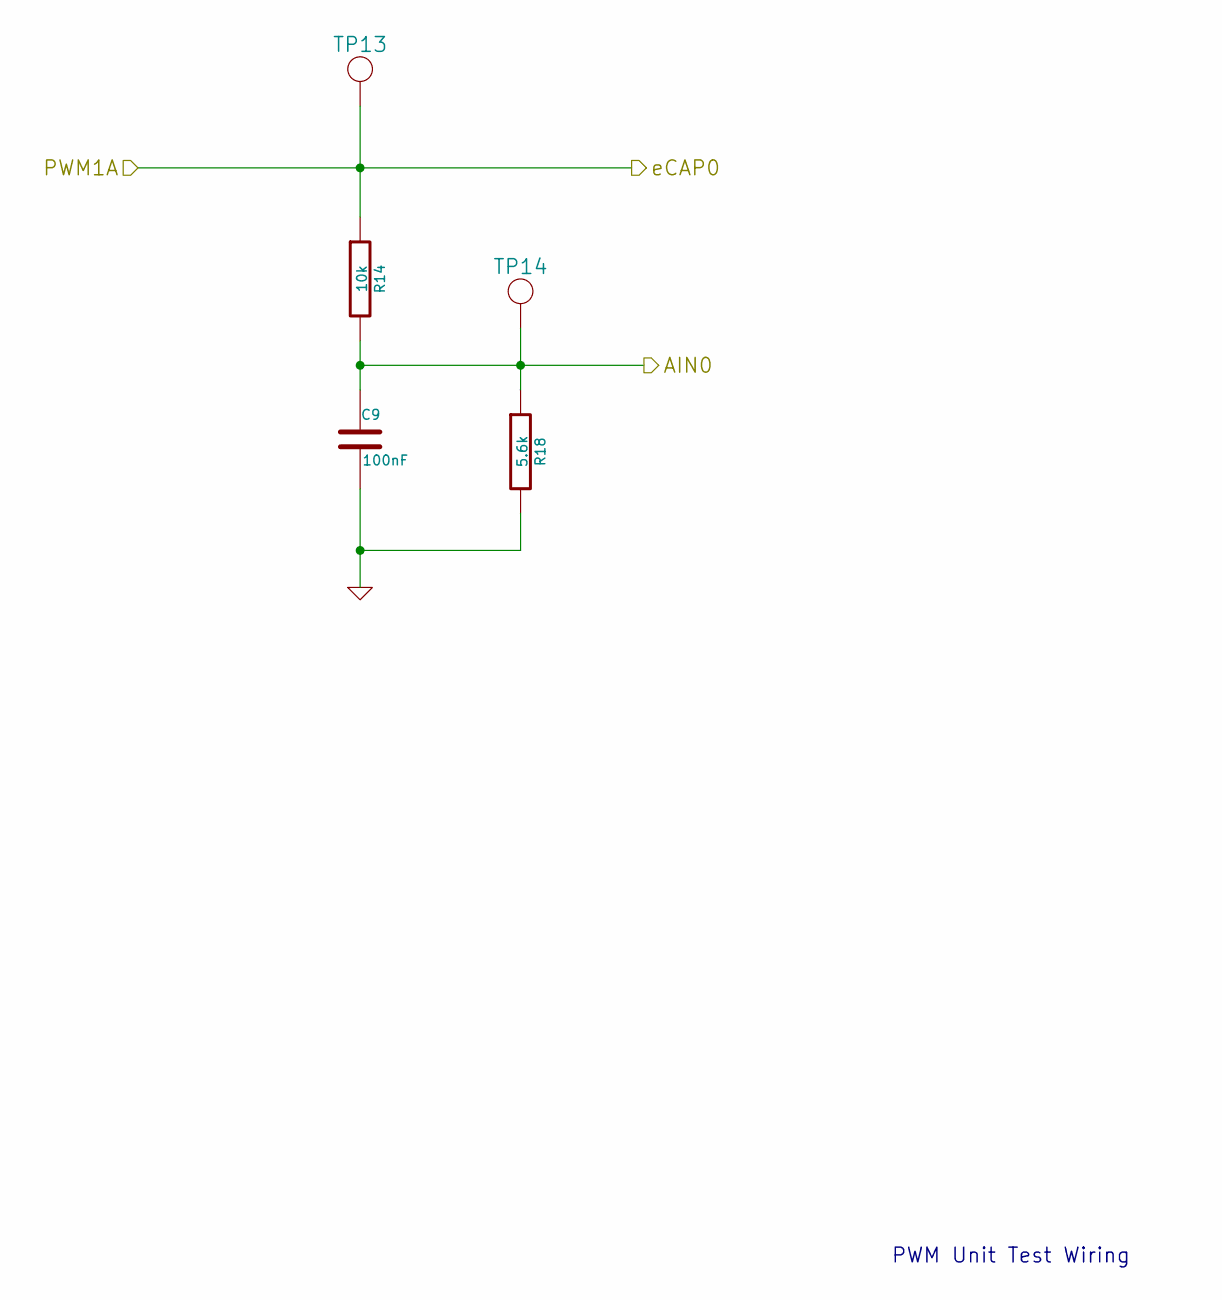
[picture p16: schematic UTCape-PWM.sch]

Parts:
C9: 100nF
R14: 10k
R18: 5.6k
TP13, TP14: TEST_POINT

Connections:
/BeagleBone Headers/AIN0: C9.1, R14.2, R18.1, TP14.1; also elsewhere on the board
/BeagleBone Headers/PWM1A: R14.1, TP13.1; also elsewhere on the board
GND: C9.2, R18.2; also elsewhere on the board

Notes on the sheet:
PWM Unit Test Wiring

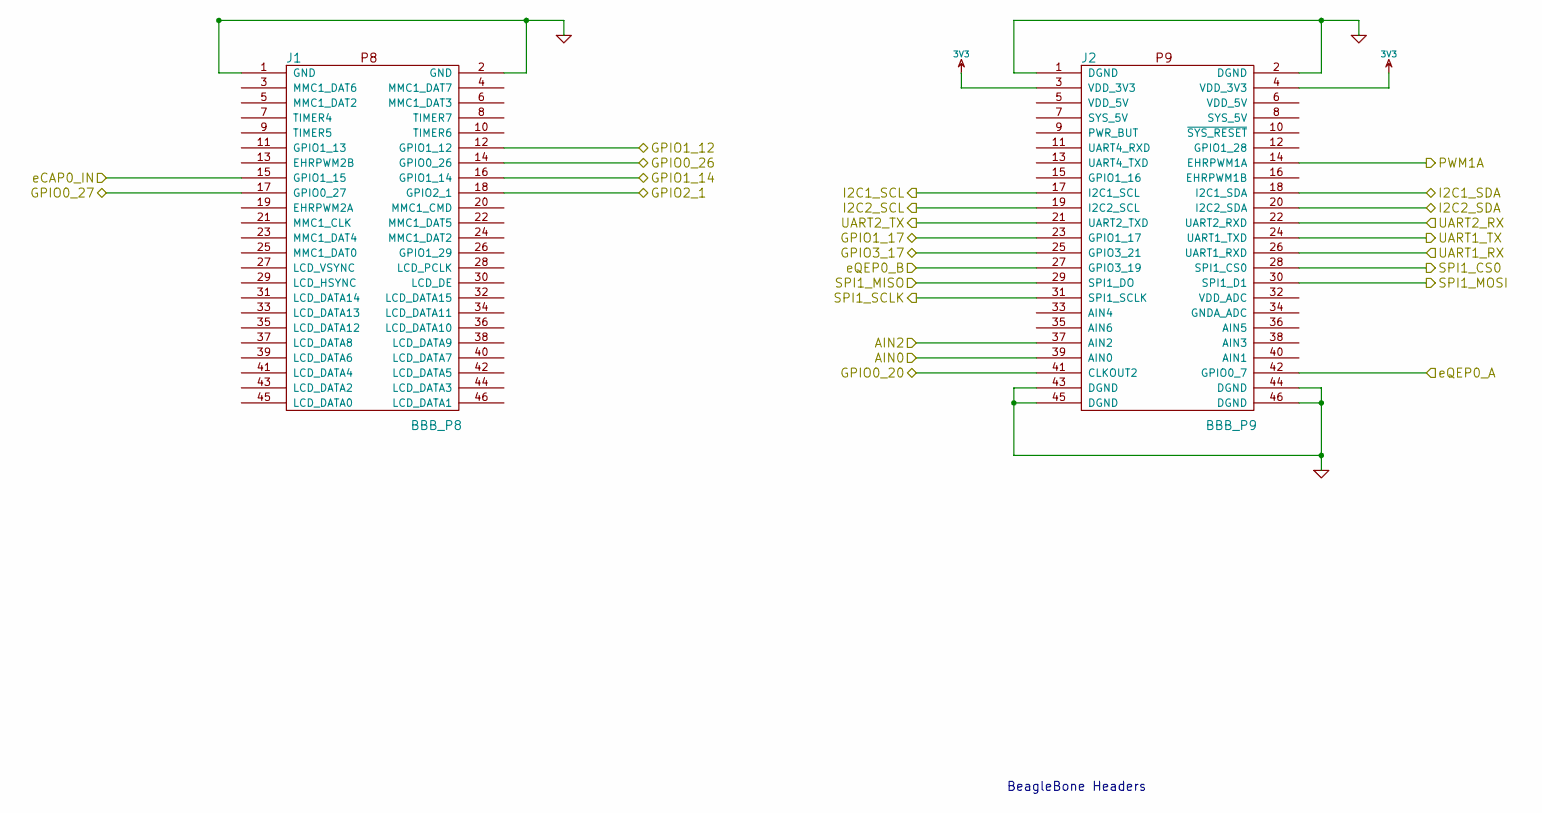
[picture p17: schematic UTCape-BBHeaders.sch]

Parts:
J1: BBB_P8
J2: BBB_P9

Connections:
3V3: J2.3 (VDD_3V3), J2.4 (VDD_3V3); also elsewhere on the board
/ADC Wiring/AIN2: J2.37 (AIN2); also elsewhere on the board
/ADC Wiring/GPIO1_17: J2.23 (GPIO1_17); also elsewhere on the board
/BeagleBone Headers/AIN0: J2.39 (AIN0); also elsewhere on the board
/BeagleBone Headers/GPIO0_20: J2.41 (CLKOUT2); also elsewhere on the board
/BeagleBone Headers/GPIO0_26: J1.14 (GPIO0_26); also elsewhere on the board
/BeagleBone Headers/GPIO0_27: J1.17 (GPIO0_27); also elsewhere on the board
/BeagleBone Headers/GPIO1_12: J1.12 (GPIO1_12); also elsewhere on the board
/BeagleBone Headers/GPIO1_14: J1.16 (GPIO1_14); also elsewhere on the board
/BeagleBone Headers/GPIO2_1: J1.18 (GPIO2_1); also elsewhere on the board
/BeagleBone Headers/GPIO3_17: J2.25 (GPIO3_21); also elsewhere on the board
/BeagleBone Headers/I2C1_SCL: J2.17 (I2C1_SCL); also elsewhere on the board
/BeagleBone Headers/I2C1_SDA: J2.18 (I2C1_SDA); also elsewhere on the board
/BeagleBone Headers/I2C2_SCL: J2.19 (I2C2_SCL); also elsewhere on the board
/BeagleBone Headers/PWM1A: J2.14 (EHRPWM1A); also elsewhere on the board
/BeagleBone Headers/UART1_RX: J2.26 (UART1_RXD); also elsewhere on the board
/BeagleBone Headers/UART1_TX: J2.24 (UART1_TXD); also elsewhere on the board
/BeagleBone Headers/UART2_RX: J2.22 (UART2_RXD); also elsewhere on the board
/BeagleBone Headers/UART2_TX: J2.21 (UART2_TXD); also elsewhere on the board
/BeagleBone Headers/eCAP0_IN: J1.15 (GPIO1_15); also elsewhere on the board
/BeagleBone Headers/eQEP0_A: J2.42 (GPIO0_7); also elsewhere on the board
/BeagleBone Headers/eQEP0_B: J2.27 (GPIO3_19); also elsewhere on the board
/I2C Wiring/I2C2_SCL: J2.20 (I2C2_SDA); also elsewhere on the board
/SPI Wiring/SPI0_CS0: J2.28 (SPI1_CS0); also elsewhere on the board
/SPI Wiring/SPI0_MISO: J2.29 (SPI1_DO); also elsewhere on the board
/SPI Wiring/SPI0_MOSI: J2.30 (SPI1_D1); also elsewhere on the board
/SPI Wiring/SPI0_SCLK: J2.31 (SPI1_SCLK); also elsewhere on the board
GND: J1.1 (GND), J1.2 (GND), J2.1 (DGND), J2.2 (DGND), J2.43 (DGND), J2.44 (DGND), J2.45 (DGND), J2.46 (DGND); also elsewhere on the board

Notes on the sheet:
BeagleBone Headers

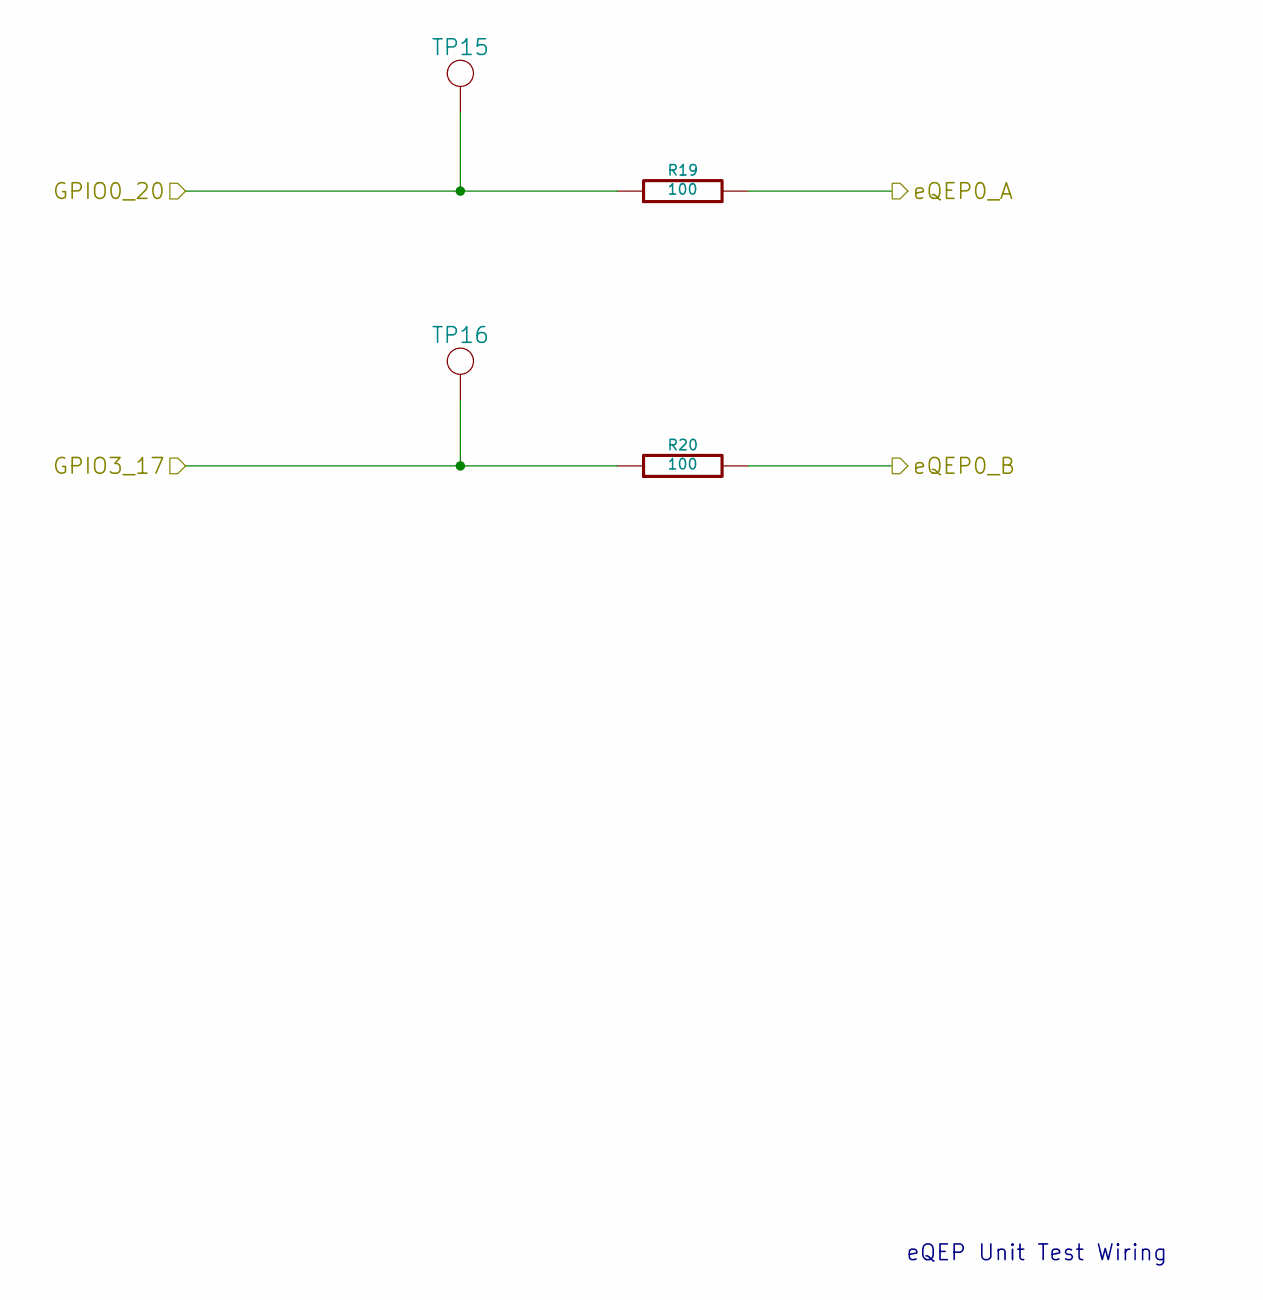
[picture p18: schematic UTCape-eQEP.sch]

Parts:
R19, R20: 100
TP15, TP16: TEST_POINT

Connections:
/BeagleBone Headers/GPIO0_20: R19.1, TP15.1; also elsewhere on the board
/BeagleBone Headers/GPIO3_17: R20.1, TP16.1; also elsewhere on the board
/BeagleBone Headers/eQEP0_A: R19.2; also elsewhere on the board
/BeagleBone Headers/eQEP0_B: R20.2; also elsewhere on the board

Notes on the sheet:
eQEP Unit Test Wiring
