graycatlabs/UTCape/UTCape-KiCad/UTCape.kicad_pcb

## KiCad design UTCape-KiCad/UTCape.kicad_pcb (continued)

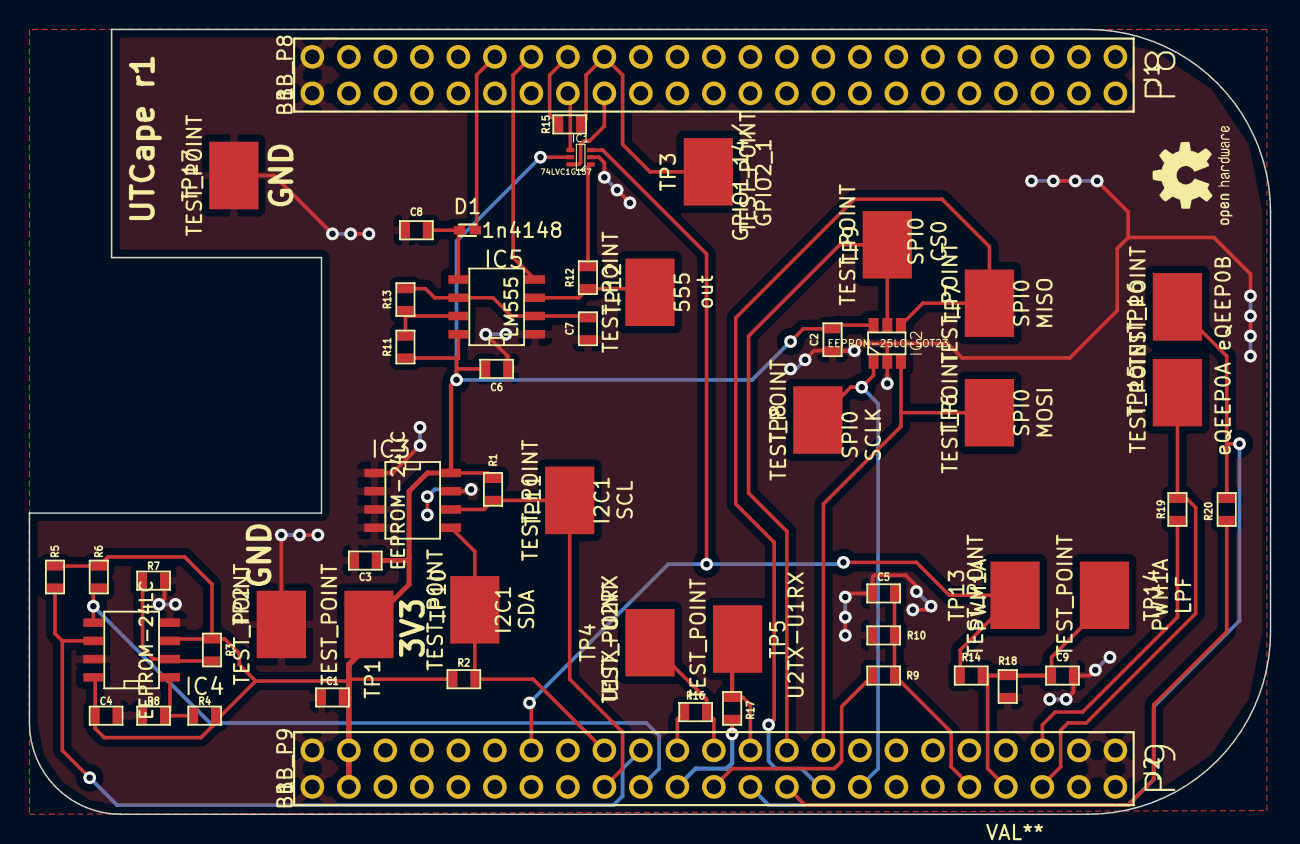
[picture p19: board UTCape.kicad_pcb from above]

Board: 2 copper layers, 86.4 x 54.6 mm, 55 parts (0 on the bottom side), 35 nets.

Other parts of the board:
BBBCapeGuide: VAL**; BBBCapeGuide
