graycatlabs/UTCape/(commit log)

2015-02-24 first commit of the UTCape
    [UTCape-ADC.sch, UTCape-BBHeaders.sch, UTCape-I2C.sch, UTCape-PWM.sch, UTCape-SPI.sch, UTCape-UART.sch, UTCape-eCAP.sch, UTCape-eQEP.sch]
2015-02-24 added missing title, created pdf of schematics
    [UTCape-ADC.sch, UTCape-BBHeaders.sch, UTCape-I2C.sch, UTCape-PWM.sch, UTCape-SPI.sch, UTCape-eCAP.sch, UTCape-eQEP.sch, UTCape.sch]
2015-02-24 cleaned up directories, added libraries
    [UTCape-ADC.sch, UTCape-BBHeaders.sch, UTCape-I2C.sch, UTCape-PWM.sch, UTCape-SPI.sch, UTCape-UART.sch, UTCape-eCAP.sch, UTCape-eQEP.sch]
2015-02-24 layed out PCB, some minor wiring changes for layout
    [UTCape-ADC.sch, UTCape-BBHeaders.sch, UTCape-I2C.sch, UTCape-PWM.sch, UTCape-SPI.sch, UTCape-UART.sch, UTCape-eCAP.sch, UTCape-eQEP.sch]
2015-02-24 generated gerber and drill files
    [UTCape-B_Cu.gbl, UTCape-B_Mask.gbs, UTCape-B_SilkS.gbo, UTCape-Edge_Cuts.gbr, UTCape-F_Cu.gtl, UTCape-F_Mask.gts, UTCape-F_SilkS.gto, UTCape.drl]
2015-03-24 added missing resistor in divider plus some protection resistors, regenerated fab files
    [UTCape-ADC.sch, UTCape-BBHeaders.sch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]
2015-03-24 added BOM
    [UTCape-bom.xlsx]
2015-03-24 moved some reference designators
    [UTCape-B_Cu.gbl, UTCape-B_Mask.gbs, UTCape-B_SilkS.gbo, UTCape-Edge_Cuts.gbr, UTCape-F_Cu.gtl, UTCape-F_Mask.gts, UTCape-F_SilkS.gto, UTCape.drl]
2015-03-25 regenerated schematic
